chaotic-distractor/optical_contacting/README.md

# optical_contacting

https://allendowney.github.io/ModSimPy/chap15.html
