chaotic-distractor/optical_contacting/_SURF2022/report/LIGO_SURF_Interim_Report_2_draft1/parts_list/interim_report2.tex

\documentclass[colorlinks=true,pdfstartview=FitV,linkcolor=blue,
            citecolor=red,urlcolor=magenta]{ligodoc}

\usepackage{graphicx}
\usepackage{amssymb}
\usepackage{amsmath}
\usepackage{longtable}
\usepackage{rotating}
\usepackage[usenames,dvipsnames]{color}
\usepackage{fancyhdr}
\usepackage{subfigure}
\usepackage{hyperref}
\usepackage{array}
\usepackage{subcaption}

\usepackage{appendix}

\title{Methods of Improving Optical Contacting

Second Interim Report}

\author{Jennifer Hritz}

\begin{document}

\section{Work completed}

Where I left off in first interim report: after spending a few weeks designing bond quality tests, I had finalize the design for heating the glass slides and was preparing to start actual bonding. Since then, I have been experimenting with the different bonding methods, exploring what factors into creating a strong bond between glass slides. For a theoretical discussion on the different bonding methods, see Appendix TBD.

\subsection{Hot plate}

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

\subsection{Bonding}

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

\begin{figure}
\begin{center}
\begin{subfigure}
  \centering
  
  \caption{After bonding attempt.}
  \label{fig:kimwipe_bond_sfig1}
\end{subfigure}
\begin{subfigure}
  \centering
  
  \caption{The bond briefly holding.}
  \label{fig:kimwipe_bond_sfig2}
\end{subfigure}
\begin{subfigure}
  \centering
  
  \caption{Failure of the bond.}
  \label{fig:kimwipe_bond_sfig3}
\end{subfigure}
\caption{These demonstrate the failure of a bonding attempt using just Kimwipes to clean the glass.}
\label{fig:kimwipe_bond}
\end{center}
\end{figure}

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

\section{Progress}

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

\section{Problems}

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

\section{Goals}

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

\end{document} 

\begin{appendices}

\section{test}

\end{appendices}
