chaotic-distractor/optical_contacting/example_docs/Ph_70_article_hritz.pdf

# Optical Contacting and Its Application in LIGO

Jennifer Hritz

Common sense dictates that joining two surfaces at room temperature is impossible without the use of an adhesive. However, doing so is in fact incredibly easy. Optically contacting, also known as direct bonding, can adhere two flat, polished surfaces simply by pressing them together. No additional substances or chemical reaction necessary! Although seemingly magical, it works by the rather simple phenomenon of van der Waals forces.
Van der Waals forces are the collective electrostatic forces between two neutral particles. The attractive potential between two particles at distance. The attractive potential V (r) between two particles at distance r can be estimated as,

V (r) = −

C
r

6

where C is the interaction constant. This means that, when we increase the distance between two particles from 1 m to 10 m, the potential decreases by a factor of 10⁶ .
In other words, the attraction between the two particles steeply drops off when they are moved even slightly farther apart. Thus, van der Waals forces are only strong at very small distances.
Van der Waals forces are actually composed of three categories of interactions: Keesom force, Debye force, and London dispersion forces [1, 2]. All of these forces relate to the electrostatic attraction of electric dipoles (Figure 1). To understand this attraction, start with the structure of molecules. All atoms have an electronegativity. This refers to an atoms tendency to attract electrons from other atoms in a chemical bond, which depends on its size and number of protons. When atoms bond together, if the difference in electronegativity is great, the resulting molecule is a polar molecule. The more electronegative atom will attract the electrons from the other atom(s) in the bond. The attracted electrons group to create a negatively charged region, while the loss of electrons in other regions creates a positive charge. The most well known example of this is water, or H2O, where oxygen is the more electronegative atom.
Polar molecules are, in essence, permanent dipoles, since an electric dipole refers to any separation of positive and negative charges. Instantaneous dipoles work on the same principle as permanent dipoles, but they are merely temporary fluctuations in the distribution of electrons. Since positive and negative charges attract, both

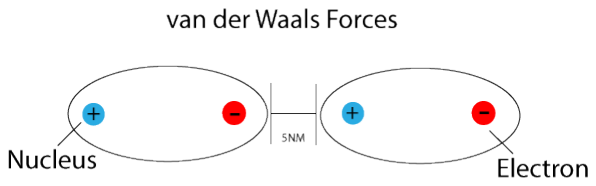
[picture p13: figure]

Figure 1: Simple diagram of van der Waals forces [a]. (https://revisionscience.com/a2-level-level-revision/chemistry-level-revision/bonding-and-structure/van-der-waals-forces)

types of dipoles play a key role in the three types of van der Whaals forces.
The first two forces, Keesom force and Debye force, are rather similar as they both arise from permanent dipoles [1]. Keesom force, also called dipole—dipole interactions, comes from the interaction energy between two permanent dipoles of moment µ1 and µ2 at distance rf,

V (r, θ1, θ2, ϕ) = −

µ1µ2(2 cos θ1 cos θ2) − sin θ1 sin θ2 cos ϕ 4πκϵ0

1
r

3

To derive the interaction, also known as the Keesom energy, we take the average over all angles weighted with the Boltzmann factor [3], which gives the ratio between two states of a system occurring. For this application, the Boltzman factor accounts for the system’s preference towards angles that have the lowest energy. Otherwise, all angles would be equally likely, leading to an average of zero. Thus, after a lengthy calculation, we get [3],

Vo(r) = ⟨V (r)⟩ = ⟨V (r, θ1, ...)e

−V (r,θ1,...)/kBT
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
(4πϵ0)

2(3kBT)

where ϵ0 is the vacuum dielectric constant, kB is the Boltzmann’s constant, and T is the absolute temperature [1, 3]. Note how it scales by a factor of 1/r⁶
Next, Debye force, also called dipole-induced-dipole interactions, results from a polar particle inducing a temporary dipole on a non-polar particle. Similar to Keesom force, for dipole moments µ1 and µ2 and polarizabilities α1 and α2 [1]:

Vi(r) = −

1
r

6

1
(4πϵ0)

2

(µ

2
1α2 + µ

2
2α1)

Once again, note how it scales by a factor of 1/r⁶ .

Finally, we have London dispersion forces, also called dispersion interactions
[2] or temporary fluctuating dipole interactions, result from instantaneous dipoles. Electrons are constantly in motion and sometimes that motion results in an uneven distribution of charge about the nucleus, creating a temporary dipole, which leads to attraction in the same way as mentioned previously. This is arguably the most important of the three van der Waals forces as it can occur between any two particles, unlike the others which necessitate inherent polarization for at least one particle. The strength of London dispersion forces depends on the size and shape of the particle. Larger molecules and atoms experience a stronger force because their valence electrons are farther from the nucleus and are therefore freer to move to induce a dipole. For molecules, some are shaped in ways that allow them to more effectively come in contact with one another [1, 4]. The time average interaction energy for polarizabilities α1 and α2 and electron orbiting frequencies ν1 and ν2 [1]:

Vd(r) ≈ −

1
r

6

3
2

α1α2
(4πϵ0)

2

ℏν1ν2
(ν1 + ν2)

where ℏ is Planck’s constant. Although redundant at this point, note one final time how it scales by a factor of 1/r⁶
Thus, if we sum these interactions, we get the total interaction energy.

V (r)vdW = Vo(r) + Vi(r) + Vd(r)

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
(4πϵ0)

2(3kBT)

+

1
(4πϵ0)

2

(µ

2
1α2 + µ

2

2α1) + 3
2

α1α2
(4πϵ0)

2

ℏν1ν2
(ν1 + ν2)

≈ −

C
r

6
Taking the negative derivative of the energy with respect to the distance to get the force [1],

FvdW (r) = −

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
we see that it scales by an even smaller factor of 1/r⁷
. Overall, this derivation emphasizes how optical contacting is theoretically possible between any two materials, and more critically, that it requires very, very small distances to be strong. The latter is most important because it is the crux for a successful direct bond. Although optical contacting could theoretically work between any two surfaces, silicon—both in its pure crystal state and as silicon dioxide in the form of glass— works best and has the largest range of applications. The name ”optical” in optical contacting refers to glass optics (Figure 2). Because these lenses are typically highly polished, their flat surfaces are perfect for bonding. The flatter the surface, the smaller the distance between the atoms, and therefore the stronger the bond.

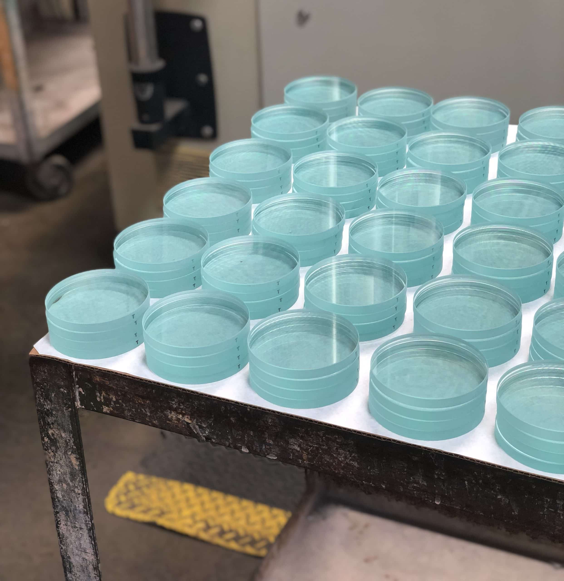
[picture p14: figure]

Figure 2: Example of optical glass [b]. (https://www.swiftglass.com/blog/what-is-optical-glass/)

So far we have only described the van der Waals interactions between two particles, not an entire lattice of atoms, but from our previous work, we can easily obtain the potential between two surfaces. For simplicity, we will ignore any repulsion; this includes repulsion from the Pauli exclusion principle, which comes from overlapping electron clouds [1]. We start by estimate the attractive forces between a particle at distance D from a plane. Integration gives us the potential between said particle and every particle in a surface with ρ particles per unit volume [5].

V (D) = Z +∞

D

dz

Z 2π

0

dϕ

Z π/2

0

dθ
ρ
−

C cos⁶
θ
z

6

× z tan θ

z
cos² θ

= −

πρC
6D³
For two surfaces, simply integrate over every particle in an additional surface of ρ

′
particles per unit volume. From this, we can get the force per unit area like before, which in this case is the bonding strength in the form of pressure.

V˜ (D) = Z +∞

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
πρρ′C
12D²

= −

πρρ′C
12D²

= −

A
12πD²

P(D) = ∂V˜ (D)
∂D =

A
6πD³
Here A = π

2ρρ′C is the Hamaker constant. For quartz glass, A ≃ 0.6 × 10⁻¹⁹J. Plugging this and experimental measurements of P(D) into the above equation, we find that the gap between the surfaces is roughly 1.9–1.2nm [5]. This is roughly equivalent to the thickness of a strand of DNA.
To actually achieve a gap this small, the two surfaces need to be carefully prepared before bonding. For glass, this means precision polishing. Ideally in a clean room, both glass and silicon wafers must be cleaned of impurities, typically with a chemical. For example, in the case of cleaning with methanol, the liquid is squeezed onto paper for cleaning optics then surface is firmly scrubbed. For glass, one should apply enough pressure to making a squeaking noise. Although performing the bond under compressed air to avoid re-contamination of dust increases the success of the bond, some success can be found even with slightly dusty conditions. In fact, while proper preparation is necessary for a strong bond, it is still relatively easy to achieve some degree of bonding, even under non-ideal conditions. As such, while optical contacting may seem like a recent invention enabled only by advances in the technology of manufacturing flat surfaces, this phenomenon has been known for at least a thousand years.
One of the first clear mentions of optical contacting comes from the 13th century Franciscan friar Bartholomaeus Anglicus [6], who wrote in his encyclopedia “On the genuine properties of heavenly, terrestrial, and infernal things:”

When a plate of gold is to be merged with or joined to a plate of silver, one needs to keep in mind three things: dust, air, and moisture. If any dust, air, or moisture comes between the two plates, they cannot be joined together, the one to the other. Therefore it is necessary to join these two metals together in a completely clean and still place. And when they are joined together in such a manner, they become so inseparable that they cannot later be taken apart. [6, 7]

This quote is included in its entirety because of how remarkably perfect it describes optical contacting hundreds of years before Johannes Diderik van der Waals was even born. We now know a bond is performed successfully, the two surface indeed effectively merge into one.
It was not until the 20th century that people began to take a closer look at optical contacting, although it was initially regarded as a nuisance. As German craftsmen perfected the art of polishing glass for optics, they observed this phenomenon, calling it “ansprengen.” In the 1930s, J.W. Obreimoff began work on measuring the strength to separate two optically contacted mica sheets. He measured the energy to split the sheets by wedging glass of thickness h in the gap between mica lamina of thickness d and a thick, parent block. This is an early example of what would become known as the ”razor test” [6].

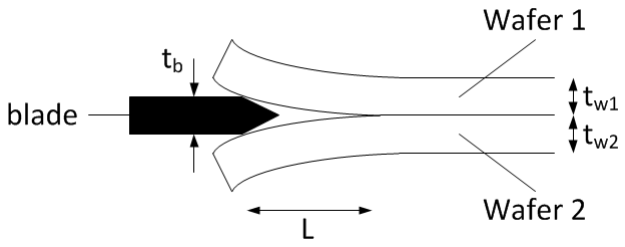
[picture p15: figure]

Figure 3: Diagram showing the razor test [c]. (https://en.wikipedia.org/wiki/Wafer_bond_characterization)

The double cantilever beam test, colloquially called the razor blade method, uses the elastic forces of the bonded surfaces to estimate bond strength. As derived in Tong and G¨osele’s ”Semiconductor Wafer Bonding” [8], let us consider a bonded pair of two beams of the same materials, both of width w. A razor blade of thickness tb is inserted in the gap between the two beams. The bent parts of each beam both have elastic energies Eelas, which is a function of their Young’s modulus E and thickness tw. At the equilibrium crack length L, the blade produces two new surfaces of area L × w. The total energy is given by

Etotal = 2(Eelas + γLw)

where γ is the surface energy of the two newly generated surfaces. Substituting in

Eelas

Etotal = 2

wEt³
wt

2
b
32L³

+ γLw

The 2 comes from the two beams having identical properties. In the case of them having dissimilar materials, we would have 2Eelas → Eelas1 + Eelas2 and 2γ → γ1 + γ2. The equilibrium between the elastic and bonding forces occurs at the critical point of Etotal.

∂Etotal
∂L = 0 → γ =

3Et³
wt

2
b
32L⁴
Thus, if the Young’s modulus E, wafer thickness tw, blade thickness tb, and crack length L are known, we can estimate the strength of the direct bond. This is important for applications of optical contacting as we need to know if the bond will be strong enough to not break under whatever stress it will experience.
Despite existing in some capacity for many years, optical contacting of both glass and silicon is still seen as a under-researched and underutilized phenomenon. One potential application is with the planned LIGO Voyager upgrade. LIGO (Laser Interferometer Gravitational-wave Observatory) is a highly sensitive detector which measures the gravitational waves produced by black hole mergers and other massive celestial events.
”Strong” gravitational waves are produced when two massive celestial objects— typically two neutron stars or two black holes—merge. The inspiral and eventual merger of two massive bodies produce waves which travel light years to be picked up by scientists on earth (Figure 4). I placed ”strong” in quotations because the strong waves we detect are actually incredibly small. Gravitational waves create distortions around the 10⁻18 meters, roughly 1000 times smaller than the diameter of a proton [9].

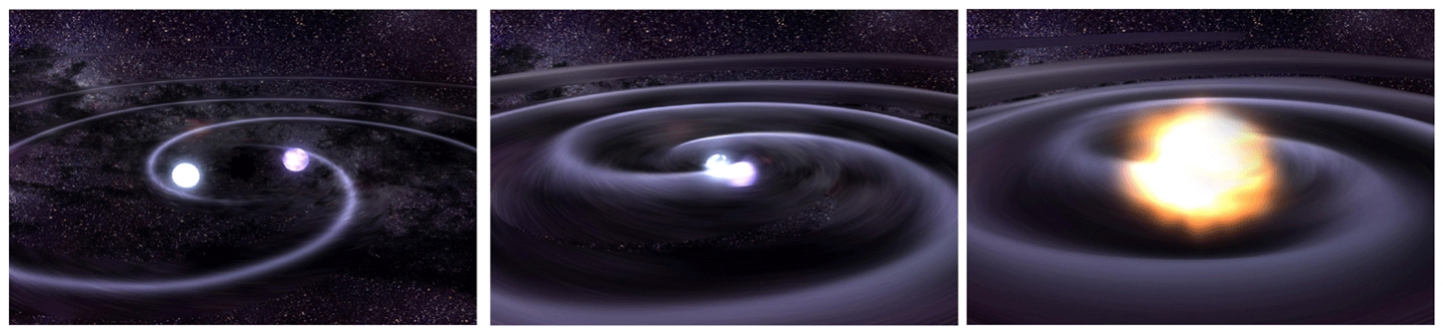
[picture p16: figure]

Figure 4: Diagram showing the razor test [d]. (https://www.ligo.org/science/GW-Inspiral.php)

NOTE (2/9/2023): The rest of this article is more or less copied from my SURF report. Re-reading it, I’m not sure if my description of suspension thermal noise is entirely accurate. I also have spent more time researching it since then, so I might write a v2 with more in-depth math/physics.

To detect something that small, we need incredibly sensitive equipment! Briefly, LIGO archives this with destructive interference between two very stable lasers. When two light beams are in the correct phase, they cancel each other out, so no light is produced. This is called destructive intereference. LIGO’s light beams bounce back and forth between two mirrors 4 km apart in a phase that perfectly destructively interferes. When the gravitation waves distort the space-time ever so slightly, the distance between the two mirrors is changed by a very small amount, shifting the phase of the beams so they no longer destructively interfere. This means that some light is able to get through, which we record as a signal [9].
Trying to keep a laser beam 4 km long—equivalent to 40 American football fields—perfectly stable is huge challenge. Although LIGO was operation starting in 2002, it would take another 13 years to first detect gravitational waves. The first iteration of the detector, Initial LIGO (iLIGO), lacked sufficient sensitivity, and it was not until the upgrade, Advanced LIGO (aLIGO), was completed in 2015 that a black hole merger was finally observed. This upgrade made the detector 10 times more sensitive. One of the major changes was to the suspension system, which holds the glass mirrors. The single pendulum was replaced with a more stable quadruple pendulum [10].
Currently, aLIGO is undergoing an upgrade called “A+” to increase the sensitivity by 50%. LIGO Voyager is a future planned upgrade which aims to be a significant improvement to aLIGO; it will extend LIGO’s range by a factor of 4-5 and increase the frequency of detections 100 fold. Voyager will increase sensitivity by limiting background noise. To archive this, one of the changes will be to replace the glass mirrors (also called test masses), and the silica fibers which suspend them, with cryogenically cooled silicon [11].
Silicon has many advantages over glass. When cooled below 123 K, it has effectively zero thermo-elastic distortion, which subsequently greatly decreases thermo-elastic noise. This makes it particularly useful for high sensitivity probes [12, 11]. The quadruple pendulum system was an upgrade to the single pendulum because the multiple pendulums increased stability thereby reducing seismic noise. It still suffers from thermal noise from the coating and suspension of the test masses, something Voyager aims to fix [13].
Suspension thermal noise arises from vibrational modes in the system. Assuming the test mass and suspension ribbons are homogenous—all silicon in the case of Voyager, the modes will be nearly orthogonal, allowing the complex system to be split into single, one-dimensional harmonic oscillators. Adding the thermal noise from each harmonic oscillator gives the total thermal noise for the modes in the system. These normal modes can be decomposed into pendulum and violin modes [14].
For the pendulum modes, consider a lossless system of a point-like mass swinging from a massless wire. The shape of this mode comes from the bending of the wire during the oscillation. The point of bending is determined by the tension from the test mass and the elastic properties of the wire. The violin modes are influenced by the same factors. The bouncing violin mode comes from the spring-like vibration of the wire [14].
Because these modes form distinctive noise peaks, they would be easy to calculate and remove from the data. However, this relies on the system being homogeneous, which it is not. Some form of adhesive must be used to attach the suspension ribbons to the test mass. Because the adhesive would have different elastic properties, the adhesive would move and flex in ways that dissipates energy and create additional, unpredictable modes. The distinctive peaks are muddled by the additional noise, making it harder for them to be removed from the data. Unlike traditional adhesives, optical contacting creates a bond which is solely composed of the two bonded surfaces. If the silicon ribbons are directly bonded to the silicon test mass, they would effectively become one homogeneous object with a well-defined set of normal modes. This is one of the many potential applications of optical contacting.

## References

[1] Zhang, X., Van der Waals Forces. Encyclopedia of Tribology (2013).
[2] Loskill, P., et al., Is adhesion superficial? Silicon wafers as a model system to study van der Waals interactions. Advances in Colloid and Interface Science (2012).
[3] https://nanohub.org/courses/AFM1/01a/asset/305
[4] https://www.chem.purdue.edu/gchelp/liquids/disperse.html
[5] Greco, V., Marchesini, F., Molesini, G., Optical contact and van der Waals interactions: the role of the surface topography in determining the bonding strength of thick glass plates. Journal of Optics A: Pure and Applied Optics (2001).
[6] Pl¨ossl, A., Krauter, G., Wafer direct bonding: tailoring adhesion between brittle materials. Materials Science and Engineering, R25 (1999).
[7] Anglicus, B., De genuinis rerum coelestium, terrestrium at inferarum proprietatibus rerum. Minerva (1964).

[8] Tong, Q.-Y., G¨osele, U., SemiConductor Wafer Bonding: Science and Technology. The Electrochemical Society Series (1999).
[9] https://www.ligo.org
[10] https://www.ligo.caltech.edu/page/about-aligo
[11] Adhikari, R., Arai, K., et al., LIGO Voyager: A Gravitational-wave Probe of Cosmology and Dark Matter. Snowmass2021 - Letter of Interest (2021).
[12] Wright, J. J., Zissa, D. E., OPTICAL CONTACTING FOR GRAVITY PROBE STAR TRACKER. 14 (1984).
[13] Westland, J., Finite Element Analysis of the Third Generation Mirror Suspension Systems for Voyager. SURF (2016).
[14] Lorenzini, M., SUSPENSION THERMAL NOISE ISSUES FOR ADVANCED GW INTERFEROMETRIC DETECTORS. UNIVERSITA’ DEGLI STUDI DI FIRENZE (2005-2007).
