chaotic-distractor/optical_contacting/for_elog/cycler_v3_graphs/PWM plates - 100 ms on, 9900 ms off.pdf

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

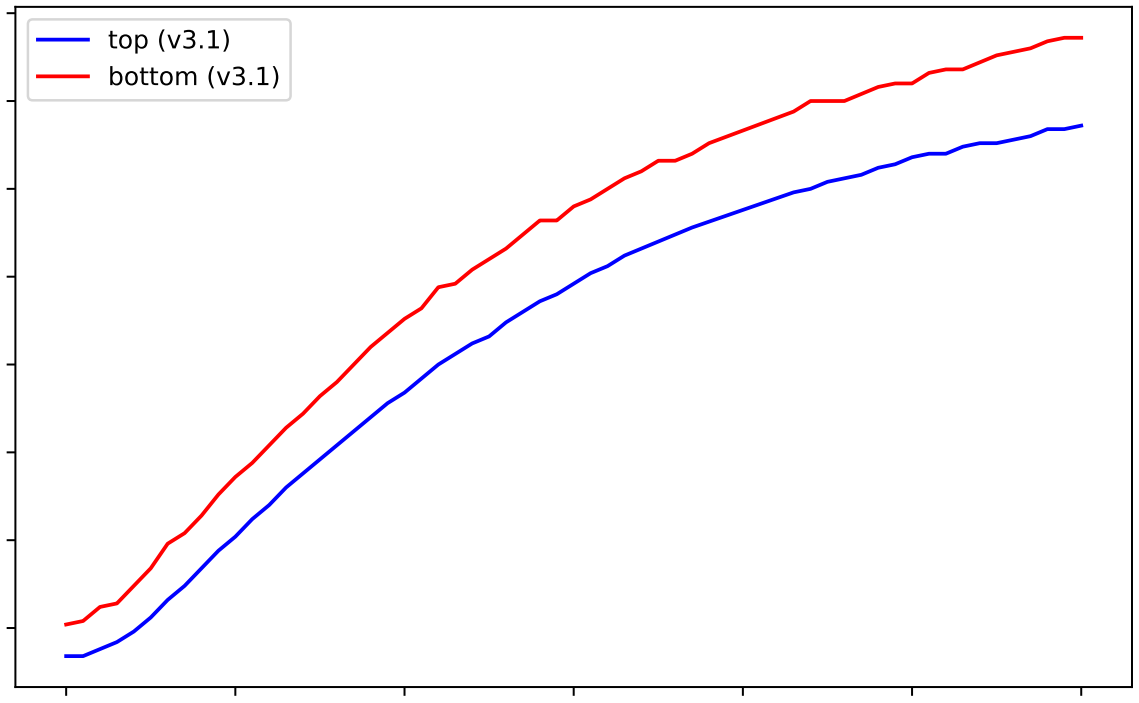
[picture p18: figure]
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
