chaotic-distractor/optical_contacting/for_elog/cycler_v3_graphs/PWM plates - 1000 ms on 9000 ms off.pdf

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

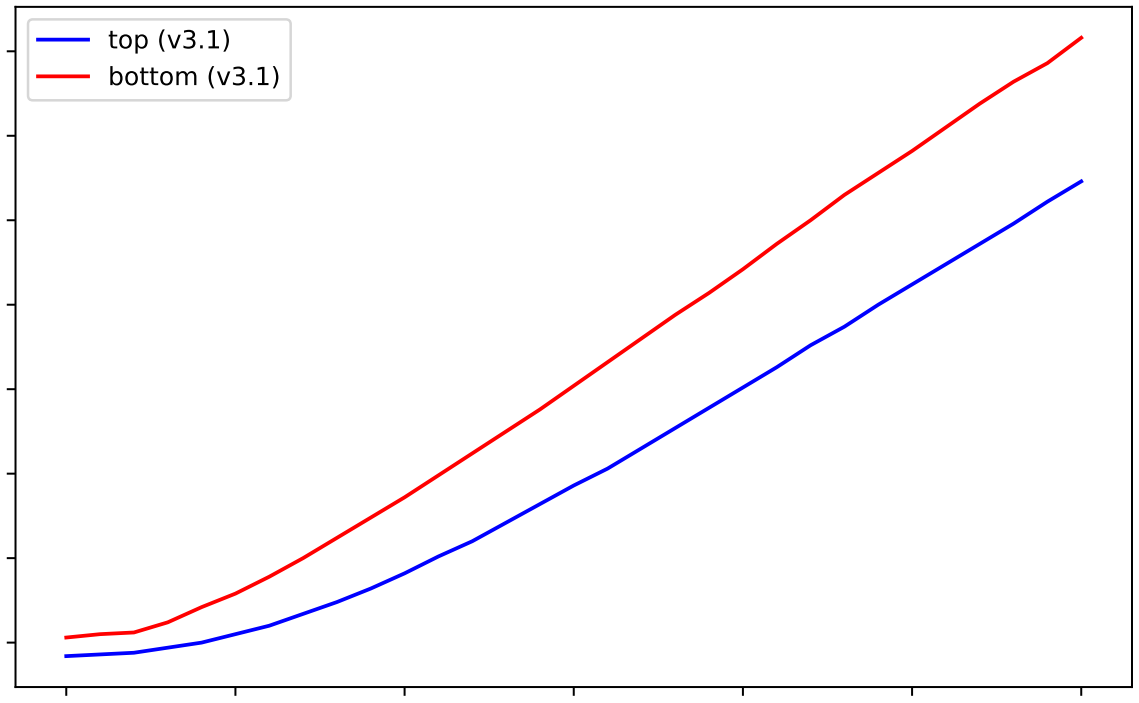
[picture p19: figure]
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
