chaotic-distractor/optical_contacting/for_elog/cycler_v3_graphs/PWM plates - increase 180°C in 10 minutes.pdf

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

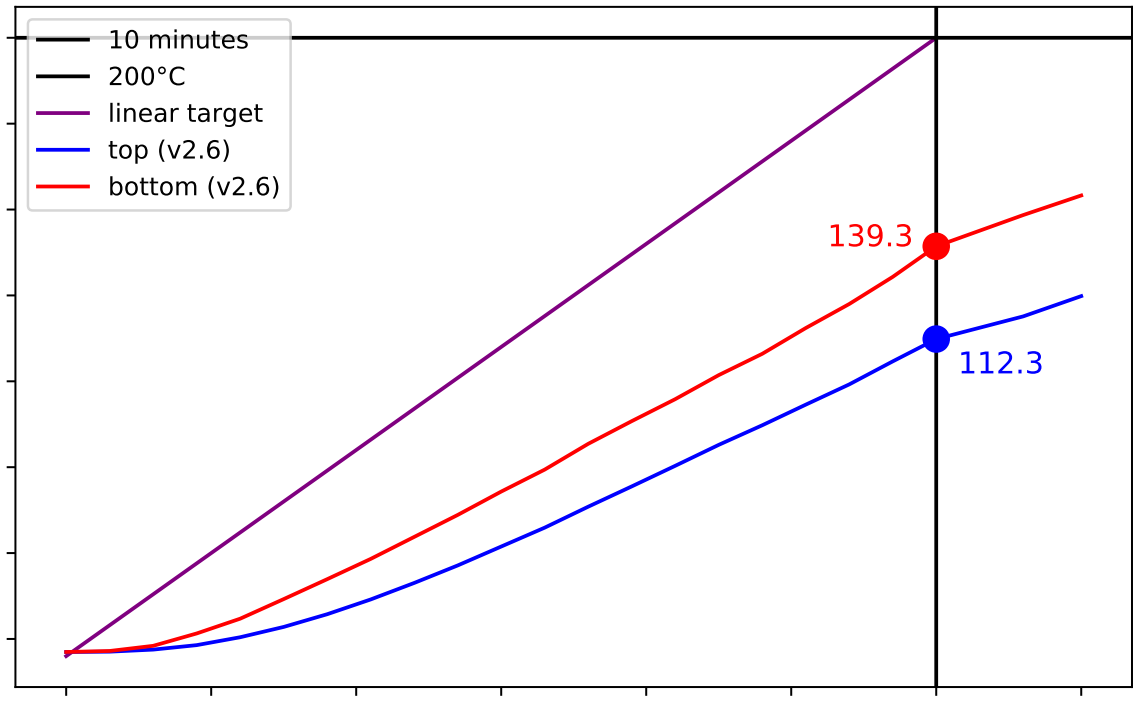
[picture p20: figure]
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
