chaotic-distractor/optical_contacting/_SURF2022/parts_list/bonding_proceedure_graphics/rough_design.jpg

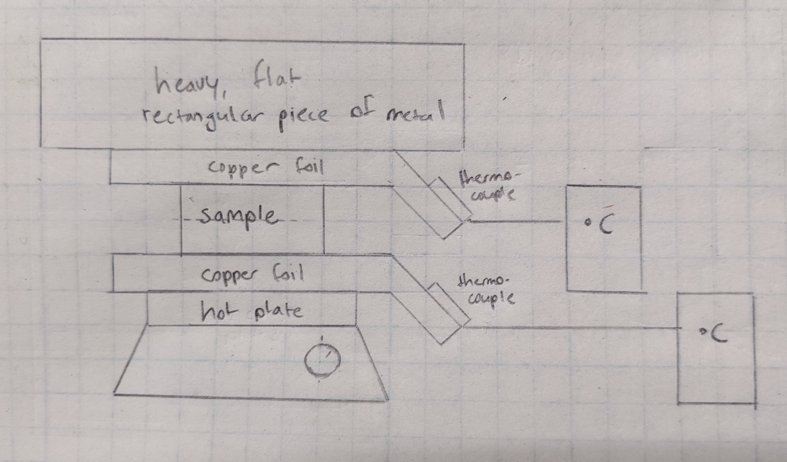
_SURF2022/parts_list/bonding_proceedure_graphics/rough_design.jpg
