chaotic-distractor/optical_contacting/_SURF2022/parts_list/shear_strength_graphics/shear_design_p2.jpg

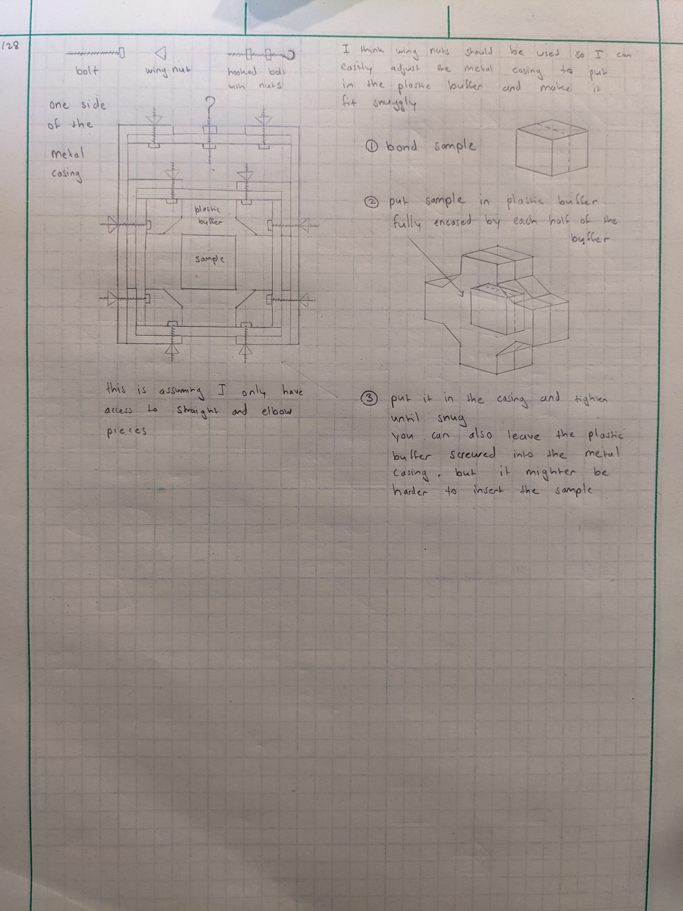
_SURF2022/parts_list/shear_strength_graphics/shear_design_p2.jpg
