chaotic-distractor/optical_contacting/_SURF2022/parts_list/shear_strength_graphics/shear_strength_overview.png

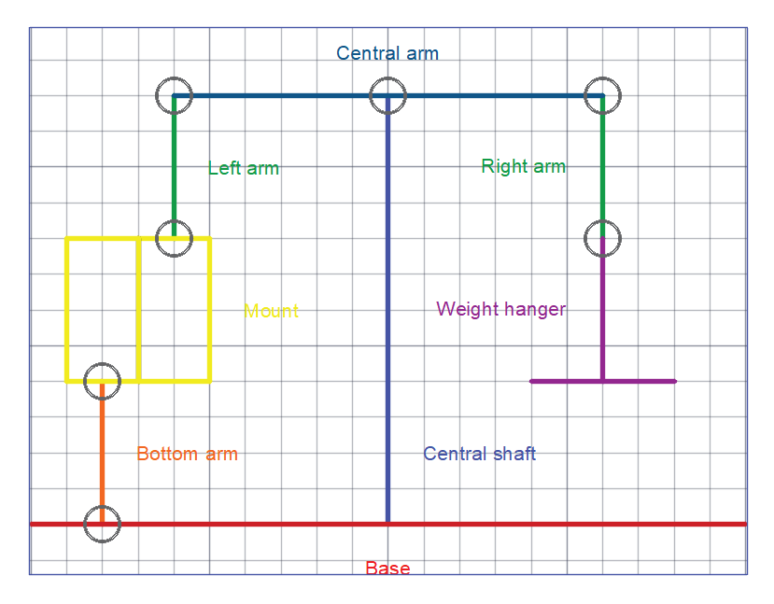
_SURF2022/parts_list/shear_strength_graphics/shear_strength_overview.png
