chaotic-distractor/optical_contacting/for_elog/lab_log_photos/2_weeks_pressure_PXL_20221004_190652540_20221017_074745619.jpg

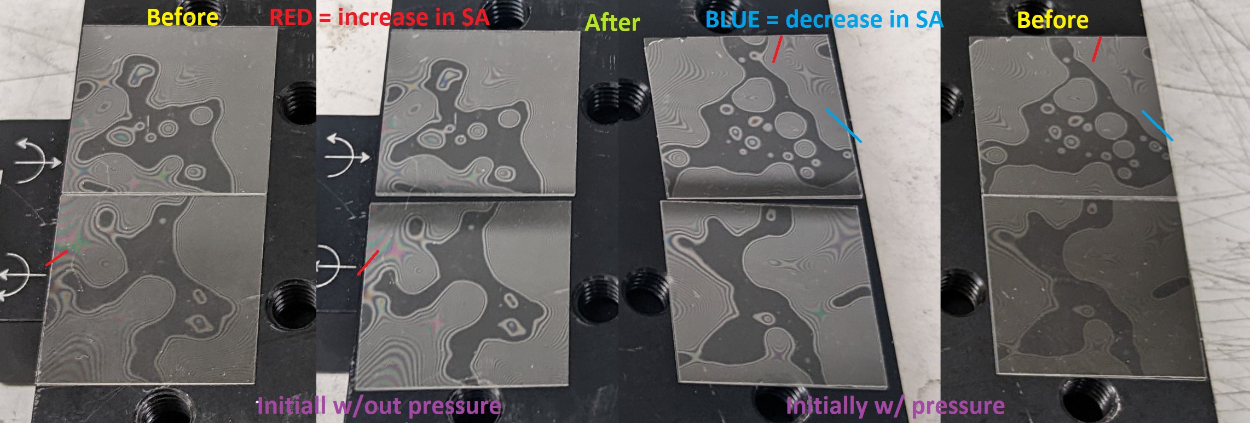
for_elog/lab_log_photos/2_weeks_pressure_PXL_20221004_190652540_20221017_074745619.jpg
