chaotic-distractor/optical_contacting/for_elog/lab_log_photos/before_time_on_left_pressure_on_right_PXL_20221003_061828860.MP.jpg

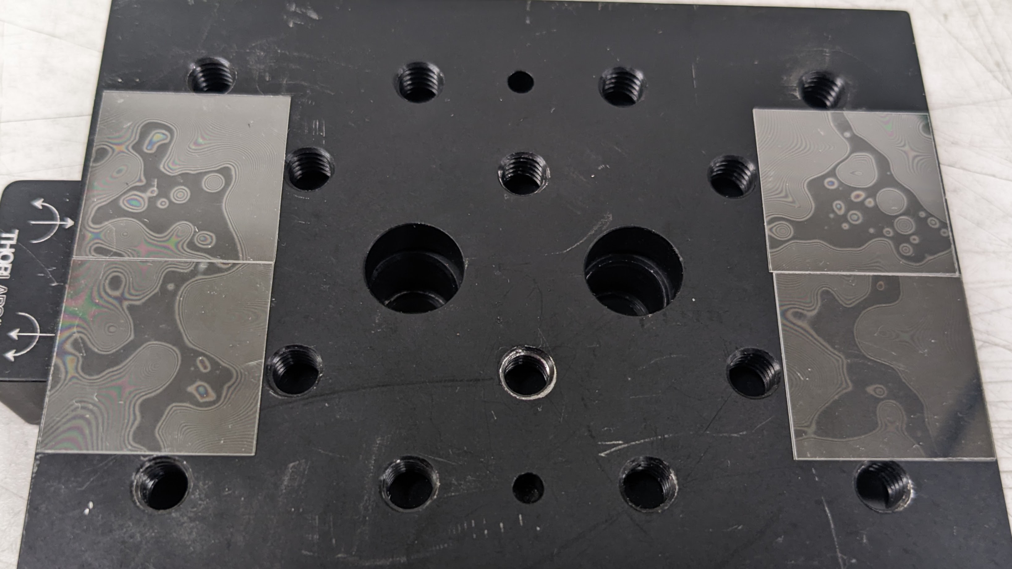
for_elog/lab_log_photos/before_time_on_left_pressure_on_right_PXL_20221003_061828860.MP.jpg
