chaotic-distractor/optical_contacting/for_elog/lab_log_photos/broken_and_fixed_thermocouple_PXL_20221020_042242792_20221020_042201775.MP.jpg

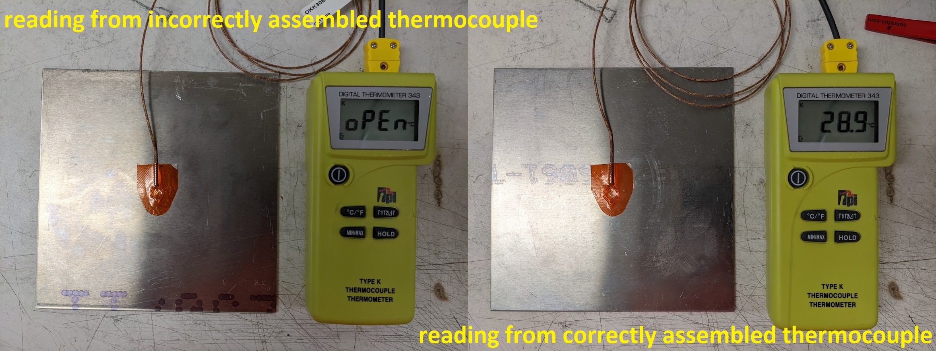
for_elog/lab_log_photos/broken_and_fixed_thermocouple_PXL_20221020_042242792_20221020_042201775.MP.jpg
