chaotic-distractor/optical_contacting/for_elog/lab_log_photos/correct_polarizatio_PXL_20221022_055117337.MP.jpg

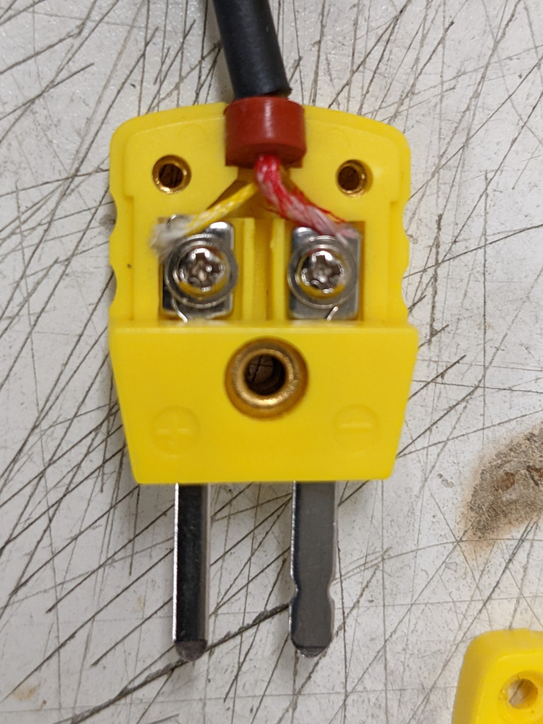
for_elog/lab_log_photos/correct_polarizatio_PXL_20221022_055117337.MP.jpg
