chaotic-distractor/optical_contacting/for_elog/lab_log_photos/heat_w_pressure_set_up_PXL_20221001_033228622.MP.jpg

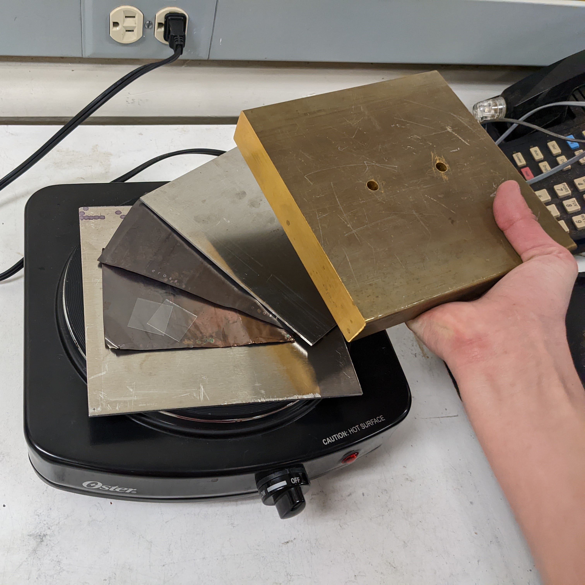
for_elog/lab_log_photos/heat_w_pressure_set_up_PXL_20221001_033228622.MP.jpg
