chaotic-distractor/optical_contacting/for_elog/lab_log_photos/in_progress_time_vs_pressure_PXL_20221003_062117715.MP.jpg

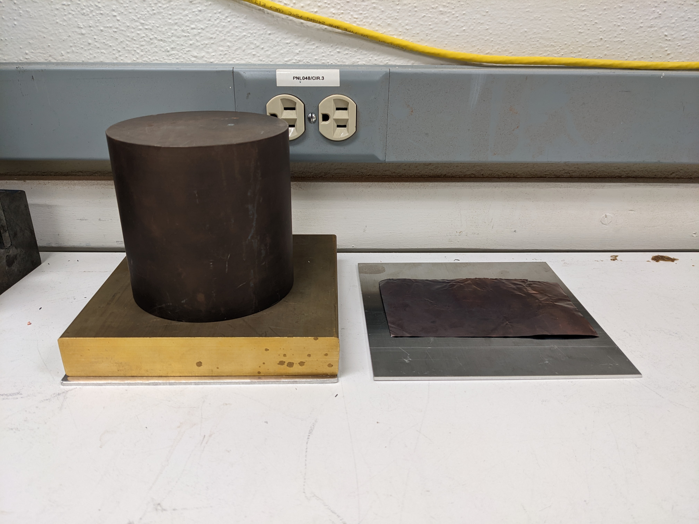
for_elog/lab_log_photos/in_progress_time_vs_pressure_PXL_20221003_062117715.MP.jpg
