chaotic-distractor/optical_contacting/for_elog/lab_log_photos/K_Type_connector_PXL_20221019_000708969.MP.jpg

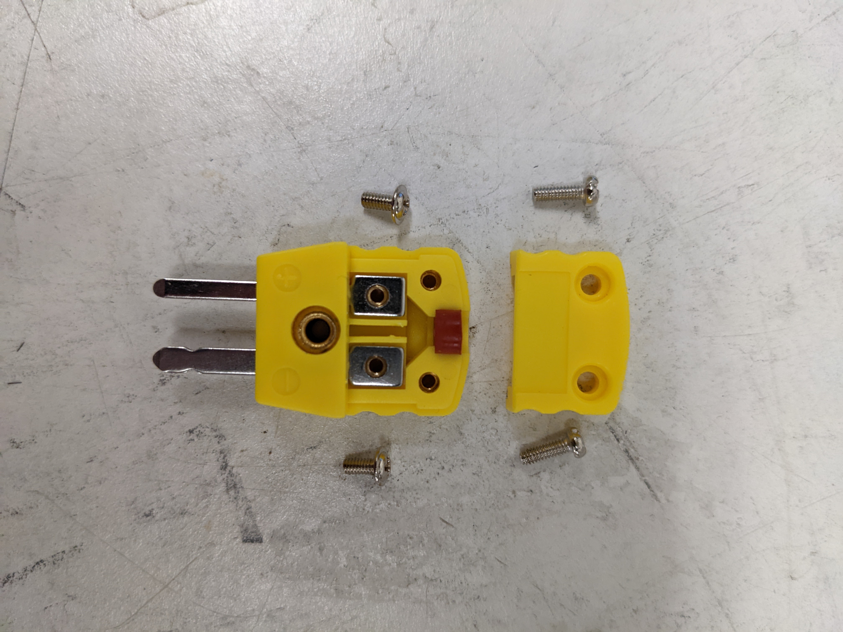
for_elog/lab_log_photos/K_Type_connector_PXL_20221019_000708969.MP.jpg
