chaotic-distractor/optical_contacting/for_elog/lab_log_photos/pressure_set_up_PXL_20221001_040539385.MP.jpg

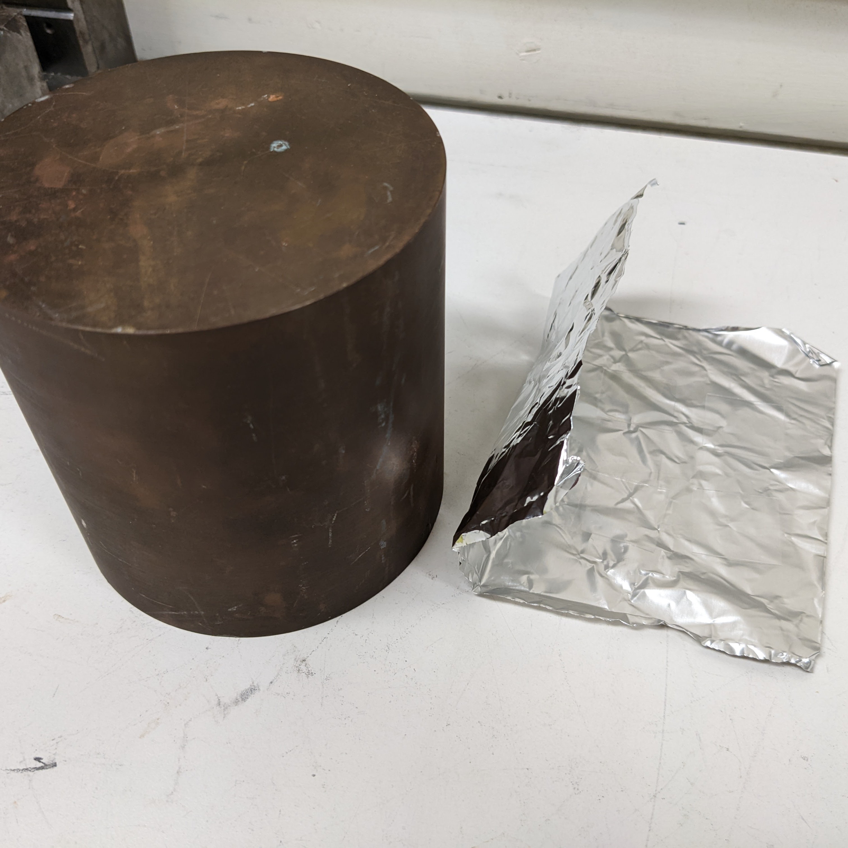
for_elog/lab_log_photos/pressure_set_up_PXL_20221001_040539385.MP.jpg
