chaotic-distractor/optical_contacting/for_elog/lab_log_photos/pressure_v_time_samples_both_PXL_20221003_061828860_20221004_190632199.jpg

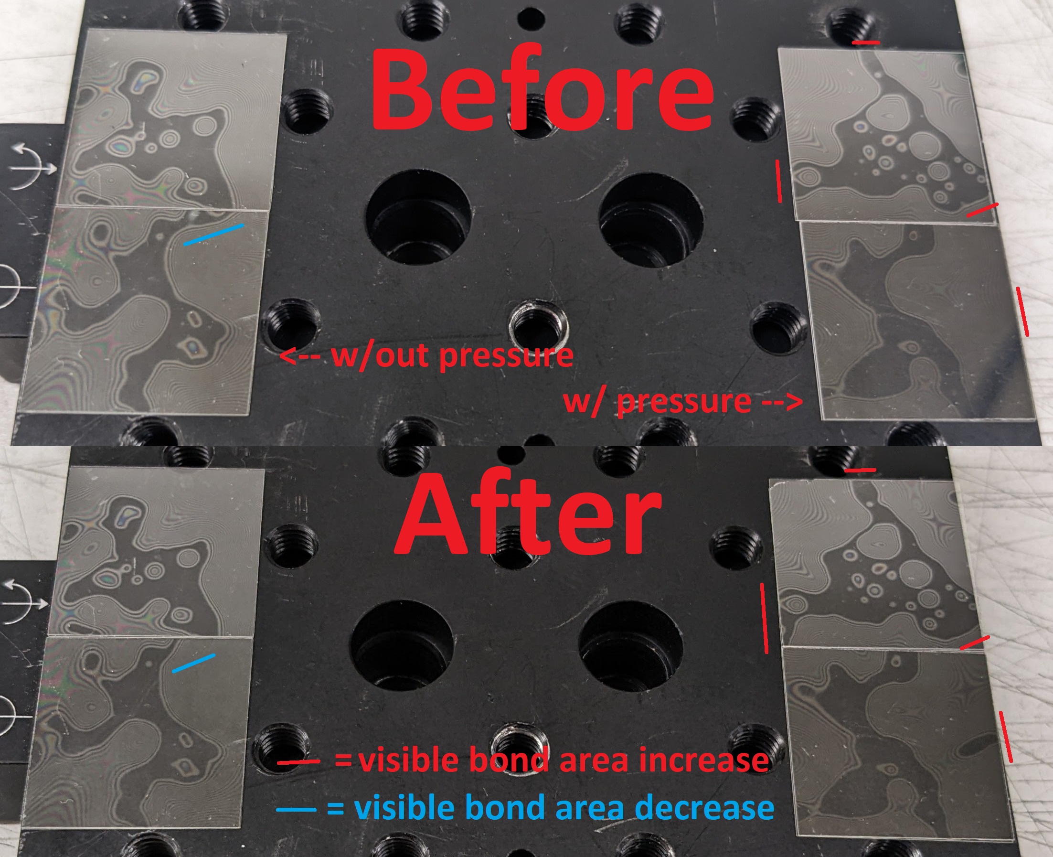
for_elog/lab_log_photos/pressure_v_time_samples_both_PXL_20221003_061828860_20221004_190632199.jpg
