chaotic-distractor/optical_contacting/for_elog/lab_log_photos/PXL_20221018_080838426.MP.jpg

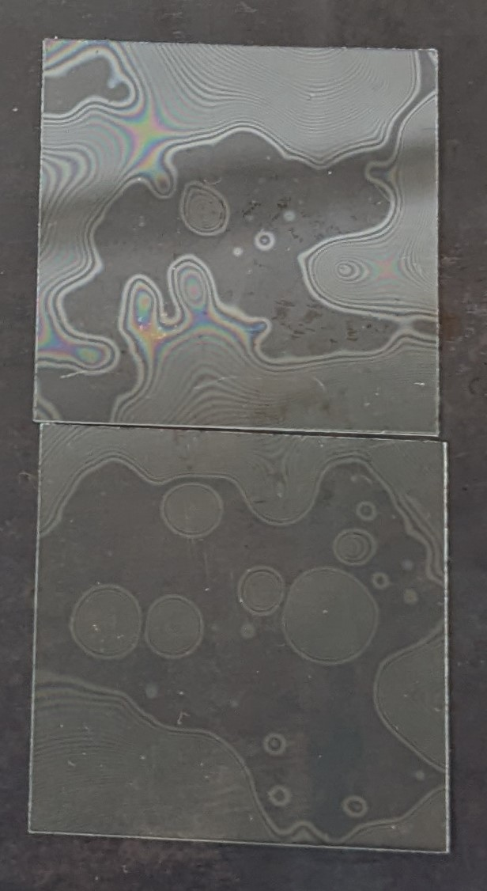
for_elog/lab_log_photos/PXL_20221018_080838426.MP.jpg
