chaotic-distractor/optical_contacting/for_elog/lab_log_photos/samples_before_AND_after_heat_w_pressure_PXL_20221002_053842185.MP.jpg

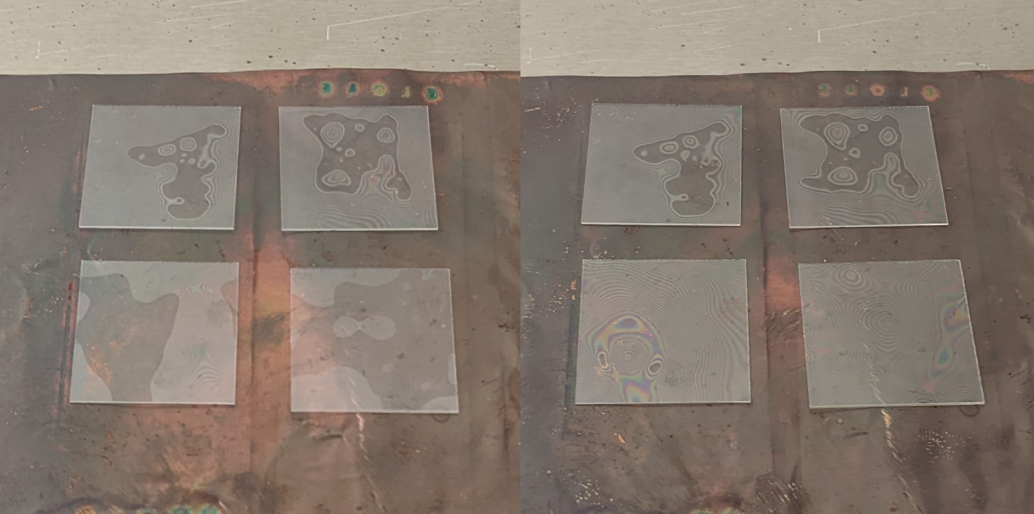
for_elog/lab_log_photos/samples_before_AND_after_heat_w_pressure_PXL_20221002_053842185.MP.jpg
