chaotic-distractor/optical_contacting/for_elog/lab_log_photos/samples_before_heat_w_pressure_PXL_20221001_034620991.MP.jpg

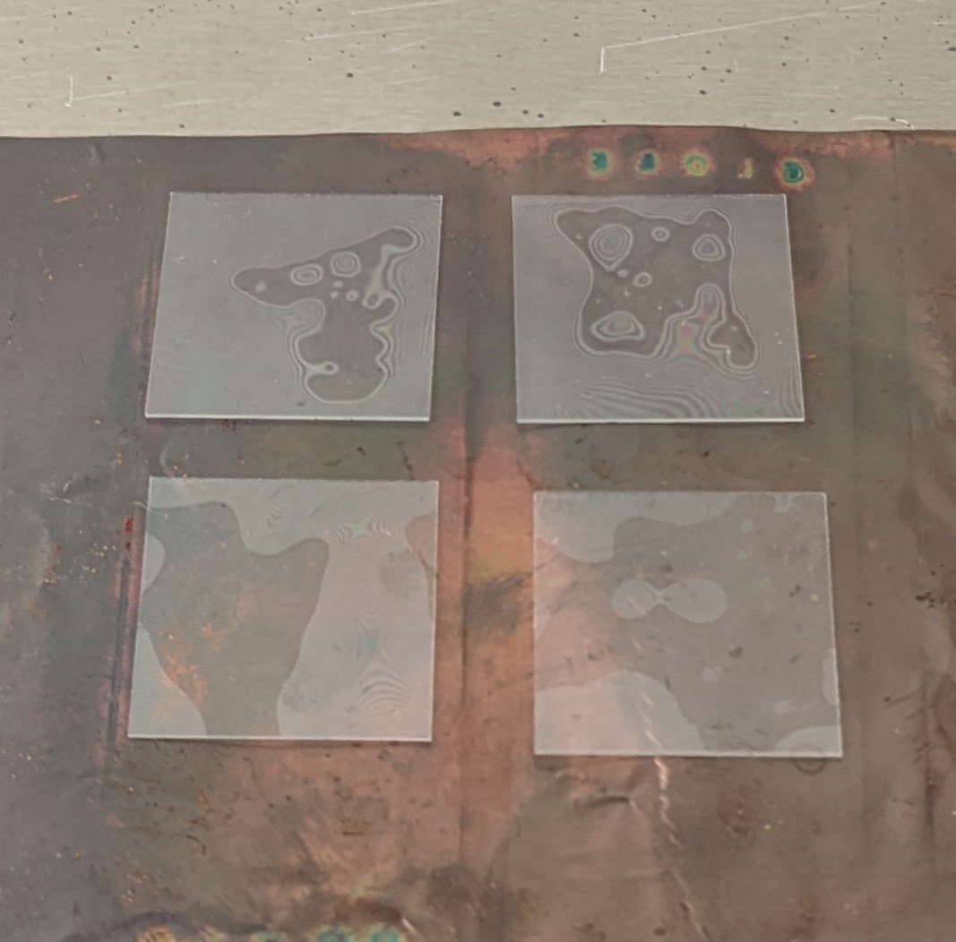
for_elog/lab_log_photos/samples_before_heat_w_pressure_PXL_20221001_034620991.MP.jpg
