chaotic-distractor/optical_contacting/for_elog/lab_log_photos/samples_before_pressure_PXL_20221001_040441662.MP.jpg

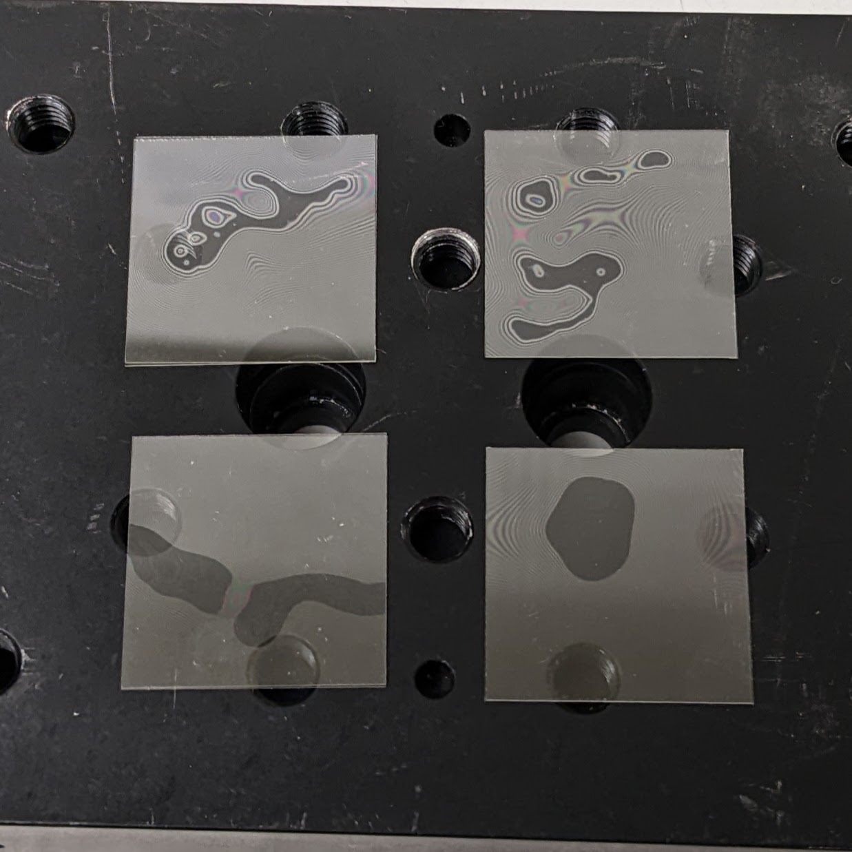
for_elog/lab_log_photos/samples_before_pressure_PXL_20221001_040441662.MP.jpg
