chaotic-distractor/optical_contacting/for_elog/lab_log_photos/thermocouples_and_thermometers_room_temp/T1_adhered_plate1_PXL_20221020_043843359.MP.jpg

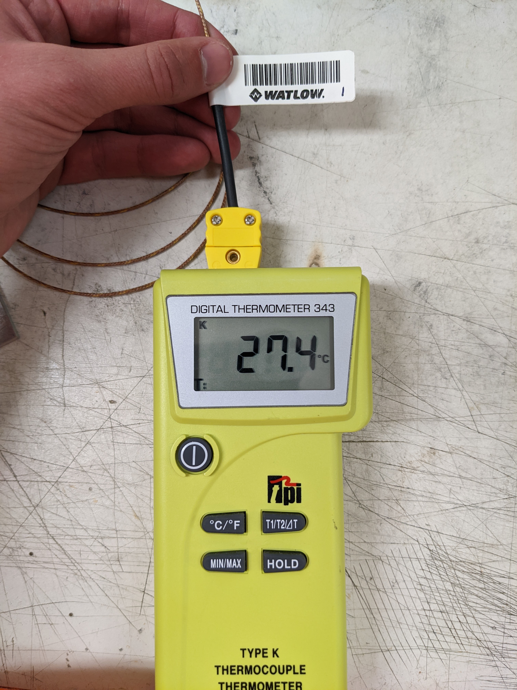
for_elog/lab_log_photos/thermocouples_and_thermometers_room_temp/T1_adhered_plate1_PXL_20221020_043843359.MP.jpg
