chaotic-distractor/optical_contacting/for_elog/lab_log_photos/thermocouples_and_thermometers_room_temp/T1_probe_plate1_PXL_20221020_044534275.MP.jpg

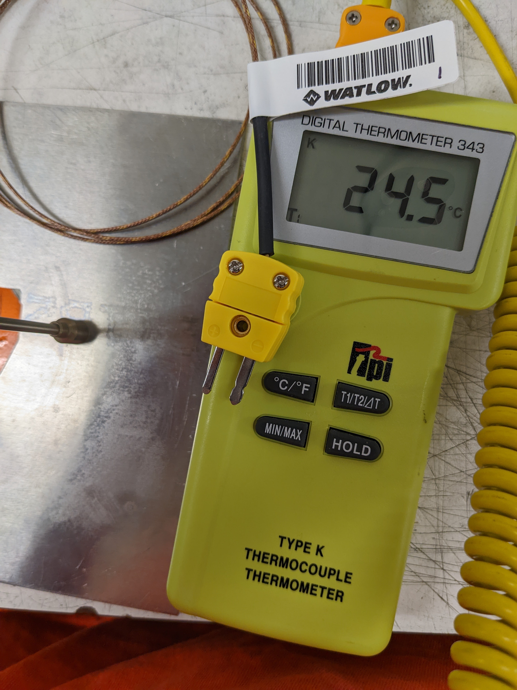
for_elog/lab_log_photos/thermocouples_and_thermometers_room_temp/T1_probe_plate1_PXL_20221020_044534275.MP.jpg
