chaotic-distractor/optical_contacting/for_elog/lab_log_photos/thermocouples_and_thermometers_room_temp/T2_probe_plate1_PXL_20221020_044446738.MP.jpg

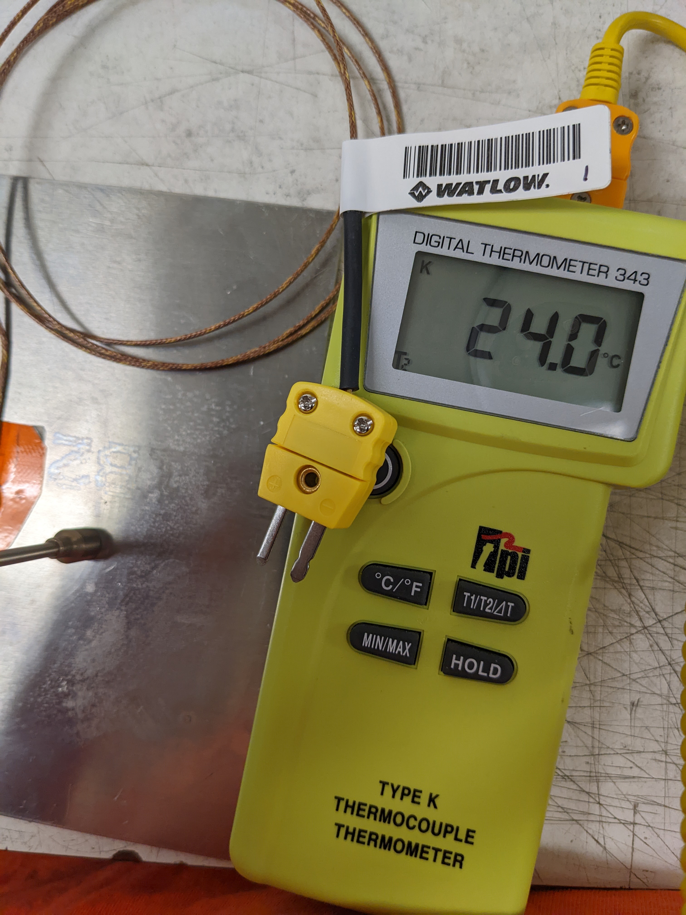
for_elog/lab_log_photos/thermocouples_and_thermometers_room_temp/T2_probe_plate1_PXL_20221020_044446738.MP.jpg
