chaotic-distractor/optical_contacting/for_elog/lab_log_photos/wrong_correct_polarization_PXL_20221022_054250498_20221022_055117337.MP.jpg

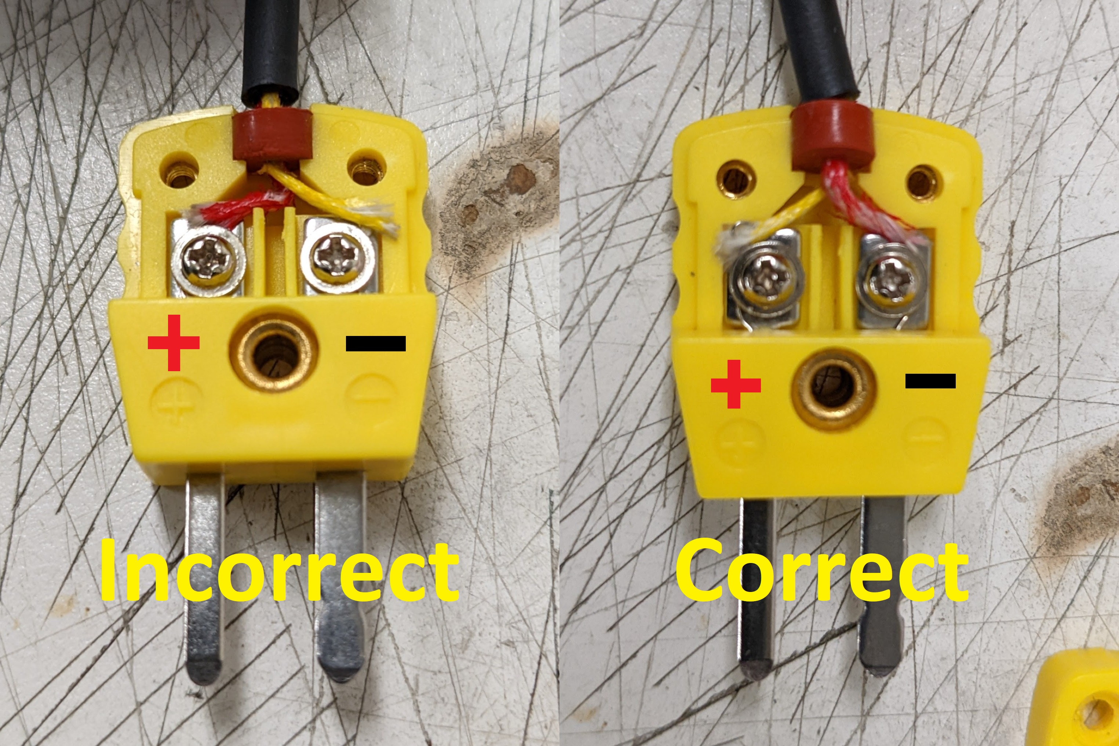
for_elog/lab_log_photos/wrong_correct_polarization_PXL_20221022_054250498_20221022_055117337.MP.jpg
