chaotic-distractor/optical_contacting/for_elog/lab_log_photos/wrong_polarization_PXL_20221022_054250498.MP.jpg

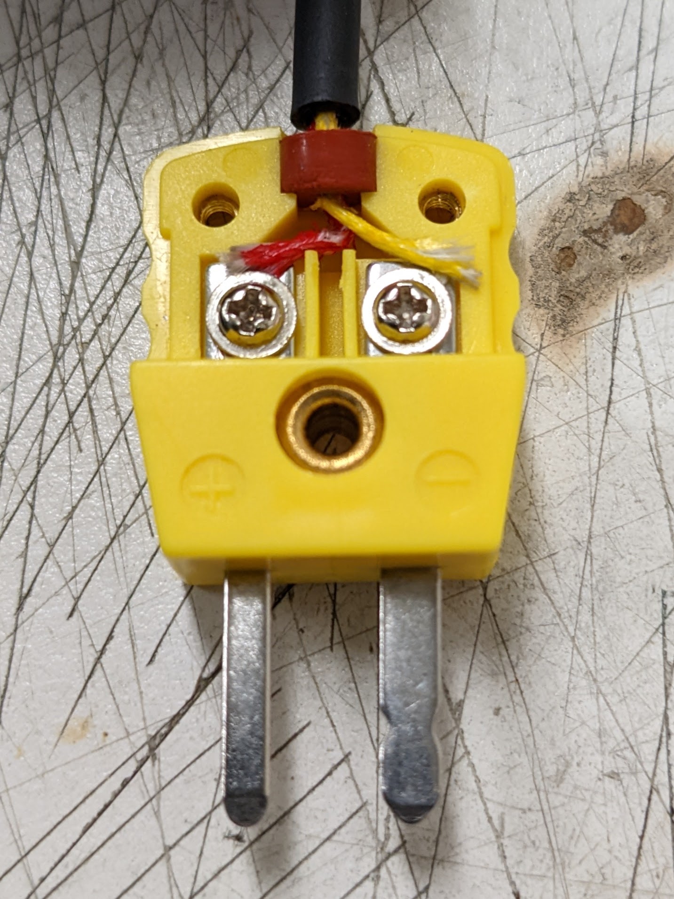
for_elog/lab_log_photos/wrong_polarization_PXL_20221022_054250498.MP.jpg
