chaotic-distractor/optical_contacting/new_hot_plate_code/Python/error_parse_raw_failed.jpg

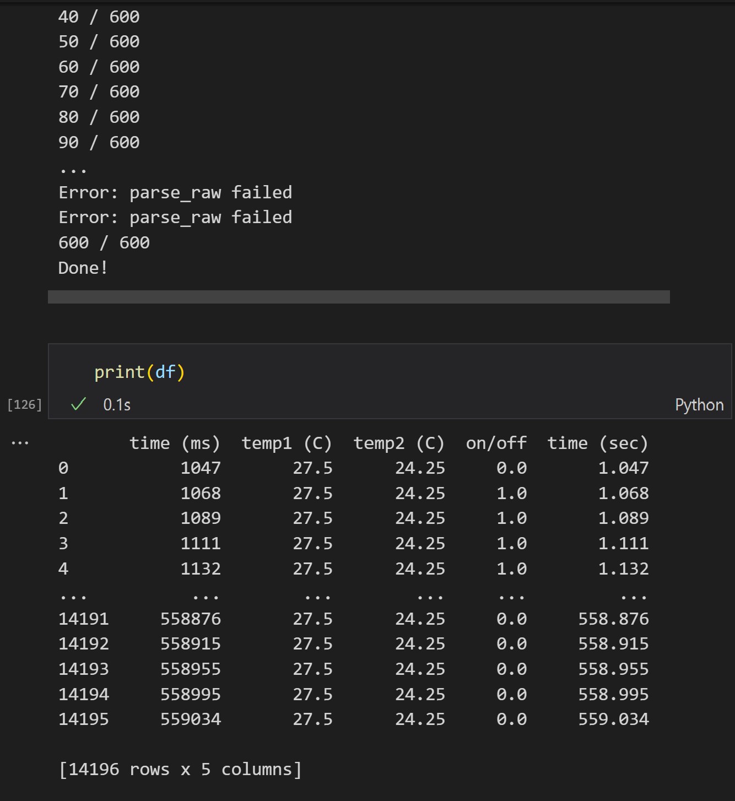
new_hot_plate_code/Python/error_parse_raw_failed.jpg
