chaotic-distractor/optical_contacting/new_hot_plate_code/Python/parse_raw_DID_NOT_fail.jpg

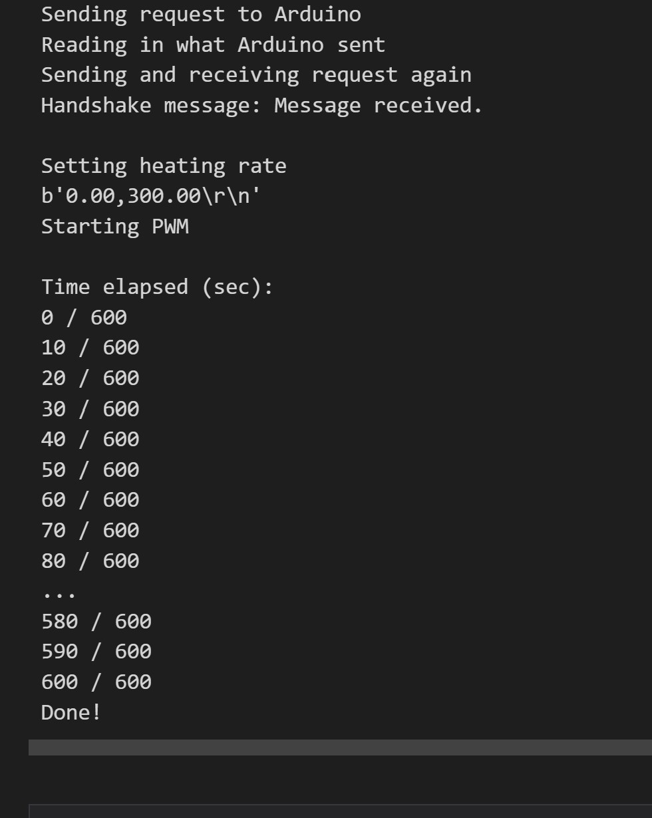
new_hot_plate_code/Python/parse_raw_DID_NOT_fail.jpg
