chaotic-distractor/optical_contacting/_SURF2022/report/LIGO_SURF_Interim_Report_2_draft1/parts_list/Appendix_parts_list.pdf

LASER INTERFEROMETER GRAVITATIONAL WAVE OBSERVATORY
- LIGO -
CALIFORNIA INSTITUTE OF TECHNOLOGY MASSACHUSETTS INSTITUTE OF TECHNOLOGY

2022/06/21

# Optical Contacting - THIS IS NOT THE ENTIRE DOCUMENT

Jennifer Hritz

California Institute of Technology | Massachusetts Institute of Technology
LIGO Project, MS 18-34 | LIGO Project, Room NW22-295
Pasadena, CA 91125 | Cambridge, MA 02139
Phone (626) 395-2129 | Phone (617) 253-4824
Fax (626) 304-9834 | Fax (617) 253-7014
E-mail: info@ligo.caltech.edu | E-mail: info@ligo.mit.edu
LIGO Hanford Observatory | LIGO Livingston Observatory
Route 10, Mile Marker 2 | 19100 LIGO Lane
Richland, WA 99352 | Livingston, LA 70754
Phone (509) 372-8106 | Phone (225) 686-3100
Fax (509) 372-8137 | Fax (225) 686-7189
E-mail: info@ligo.caltech.edu | E-mail: info@ligo.caltech.edu

http://www.ligo.caltech.edu/

## 1 Appendix # - Parts List/Experiment Design

### 1.1 Shear strength

My design was inspired by the apparatus used in a paper which was measuring the shear strength of a glass-glass direct bond [1]. The paper had a picture of their apparatus (Figure
1) but did not explain how their apparatus was constructed—most importantly, they did not explain how they mounted their wafers—so I had to design that myself.


Figure 1: ”Photograph of the setup used for shear strength measurements.” [1].

The shear strength is measured by mounting the optically bonded wafers on one side of a beam balance then slowly adding weight to the other side until the bond is broken. As shown in Figure 2, the bonded wafers are mounted such that weight pulls up one side while the other remains secure. A lab jack is used to assist with adding the weights.


Figure 2: My design of my apparatus and the mount for the bonded wafers as well as a crude diagram of how the apparatus functions.

Parts list:

1. Traditional beam balance
- I am not sure if this can be purchased or it will need to be constructed. It seems simple enough to me, but I could be underestimating its complexity.
- If it needs to be constructed, I can put together a list of the parts needed.
2. Various weights (total to roughly 100 kg)
- The idea is to slowly add smaller weights until you reach a certain amount then remove them and add a big single weight equivalent to their weight. Repeat until failure.
- I swear I have seen weights like in Figure 1 used in a lab class, so I presume they are not something that needs to be purchased.
3. Lab jack
- This is for taking the weight off the bonded wafers while replacing the smaller weights with the big single weight.
4. Mount for bonded wafers
- This was the hardest part to design since it needs to be a snug fit while also being capable of bearing weight. My idea is to 3D print a casing like in Figure 2. I am unsure if I can 3D print with a material strong enough to bear the weight, so perhaps metal should be attached around them. The mount is attached to the beam balance with a hook.
5. Bonded wafers
- These will be on the OOM of 10mm x 10m x 1mm. If it is cheaper/quicker to get a slightly different thickness (0.5mm looked more common based on a quick Internet search), that will work as well.
- It has to be fairly small otherwise it will be infeasible to add enough weight to break the bonds. The inspirational paper used similar OOM glass wafers and reported 75kg being the max it took to break them.

### 1.2 Index of refraction

Finding the absolute thickness and index of refraction of a thin film requires a technique known as ellipsometry. Basic ellipsometry is shown in Figure 3. It works on the principal that the polarization of incident light changes upon reflection against a sample [2]. Since I am working with layers, my set up will look more like Figure 4.

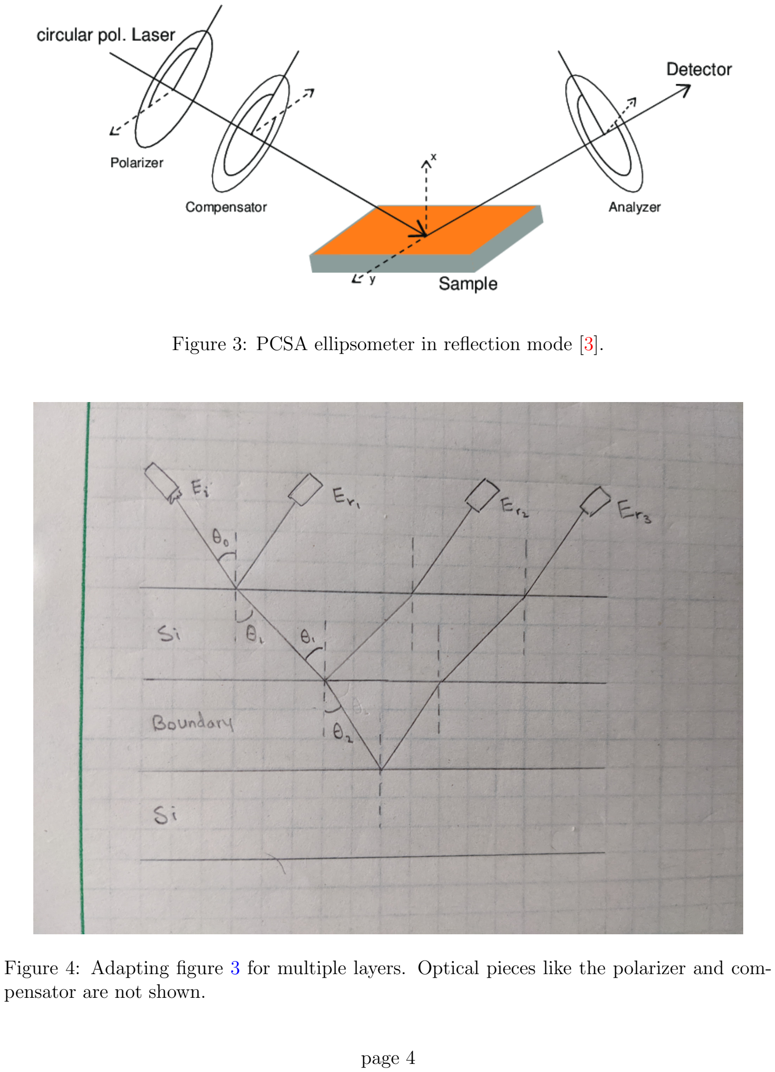
[picture p60: page 5]

Figure 3: PCSA ellipsometer in reflection mode [3].

Figure 4: Adapting figure 3 for multiple layers. Optical pieces like the polarizer and compensator are not shown.

Basic parts list:

1. Laser source
- It will be 1550 nm.
- I may be able to replace it with an IR LED.
2. Linear polarizer
3. Compensator (optional?)
- ”Introduces a defined phase retardation of one field component with respect to the orthogonal field component, the sample S, the analyzer A, and a detector” [3].
- I am a bit confused on what this part does, to be frank. It appears to be optional for reasons that I do not understand.
4. Sample
- I believe I will be able to use the same size wafers as the shear strength experiment. As I will elucidate after this list, I have been struggling with doing the exact math, so this is just based on reading a several papers which used OOM 10mm x 10m x 1mm thin films.
5. Detector

Actually putting this technique into practice is not straightforward—at least for someone like me who does not have an abundance of experience with experimental optics, although based on the papers I read, this does appear to be a difficult problem in general. The math is all linear algebra, but due to the number of variables, actually doing the calculations is quite overwhelming, especially when I am struggling to understand what is happening conceptually. Having an unknown index of refraction and an unknown thickness adds a lot of complexity to the problem, and some sources imply that it may not be able to resolve both values, or you may only be able to find a relative value [4]. There are also limits to capabilities of ellipsometry, as the changes in index of refraction may be so small that they are virtually undetectable [5]. The diagram in Figure 3 is also considered the simplest case; due to the complexity of my specific experiment, I may need to use a more complicated form of ellipsometry.

### 1.3 Mechanical q

In progress...

## References

[1] H´elie, David, et al., Reinforced direct bonding of optical materials by femtosecond laser welding. Applied optics 51.12 p.2098-2106 (2012).
[2] He, Mengfei, and Sidney R. Nagel, Ellipsometry of layered systems. Optical Characterization of Thin Solid Films. Springer, Cham, p.233-267 (2018).
[3] Kurz, Volker Luiz Siegmar., Orientation, conformation and phase transitions of thin polymer films and self-assembled monolayers studied by SFG spectroscopy. Diss. (2010).
[4] Zawada, A., Determining the refractive index, absolute thickness and local slope of a thin transparent film using multi-wavelength and multi-incident-angle interference. Optics Express 28.16 p.24198-24213 (2020).
[5] Kalkowski, Gerhard, et al., Glass-glass direct bonding. ECS Transactions 64.5 p.3 (2014).
