chaotic-distractor/optical_contacting/_SURF2022/parts_list/graphics/basic_ellipsometry.jpg

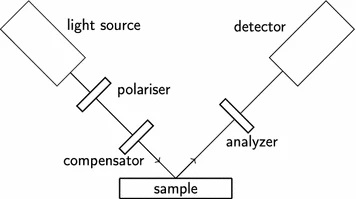
_SURF2022/parts_list/graphics/basic_ellipsometry.jpg
