chaotic-distractor/optical_contacting/_SURF2022/report/LIGO_SURF_Interim_Report_2_draft1/parts_list/graphics/elbow_PXL_20220712_223449788.MP.jpg

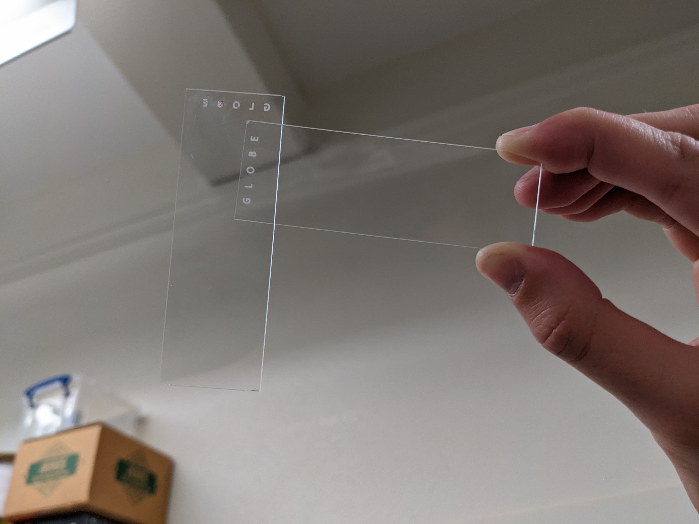
_SURF2022/report/LIGO_SURF_Interim_Report_2_draft1/parts_list/graphics/elbow_PXL_20220712_223449788.MP.jpg
