chaotic-distractor/optical_contacting/for_elog/lab_log_photos/correct_assembly_PXL_20221020_042855181.MP.jpg

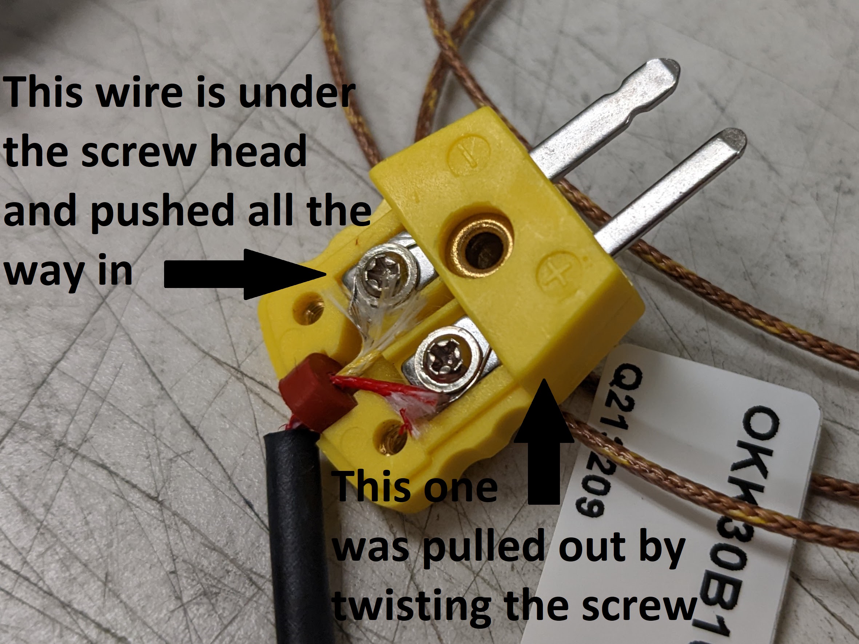
for_elog/lab_log_photos/correct_assembly_PXL_20221020_042855181.MP.jpg
