chaotic-distractor/optical_contacting/for_elog/cycler_v1_graphs/PWM_test_2.txt

0	20.2
30	22.9
60	30.9
90	40.2
120	48.9
150	56.6
180	64.2
210	71.5
240	79.9
270	85.9
300	92.2
330	98.5
360	104.5
390	110.3
420	116.0
450	120.3
480	125.3
510	129.5
540	133.7
570	138.5
600	142.9
630	146.1
660	150.0
690	153.4
720	156.6
750	159.7
780	162.1
810	164.5
840	167.3
870	169.7
900	171.4
930	173.4
960	174.8
990	176.7
1020	178.1
1050	180.0
1080	181.4
1110	182.7
1140	184.1
1170	185.2
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
