chaotic-distractor/optical_contacting/for_elog/cycler_v1_graphs/PWM_test_3.txt

0	20.6
30	25.7
60	40.6
90	57.5
120	74.4
150	89.8
180	105.1
210	117.8
240	129.8
270	141.7
300	152.9
330	162.9
360	172.4
390	180.9
420	188.9
450	195.9
480	203.5
510	194.2
540	197.3
570	201.4
600	205.2
630	209.2
660	214.0
690	217.0
720	220.2
750	221.9
