chaotic-distractor/optical_contacting/for_elog/cycler_v2_graphs/PWM_v2.2_test1_actual.txt

0	21.2
15	21.8
30	27.1
45	32.4
60	37.5
75	42.8
90	48.6
105	54.0
120	59.1
135	64.3
150	69.6
165	74.6
180	79.7
195	84.7
210	89.3
225	94.0
240	98.4
255	103.0
270	107.3
285	111.9
300	115.4
315	119.7
330	123.6
345	127.3
360	129.9
375	134.5
390	138.0
405	141.2
420	143.6
435	147.2
450	150.5
465	157.0
480	169.9
495	183.5
510	196.3
525	208.1
540	220.5
555	232.4
570	243.6
585	254.2
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
