chaotic-distractor/optical_contacting/for_elog/cycler_v2_graphs/PWM_v2.3_test1_actual.txt

0	21.9
15	22.8
30	28.6
45	34.2
60	39.8
75	45.0
90	51.1
105	56.6
120	62.2
135	67.5
150	72.6
165	77.9
180	83.4
195	88.2
210	93.1
225	97.6
240	102.2
255	106.6
270	110.9
285	115.0
300	119.2
315	123.2
330	127.0
345	130.6
360	134.6
375	137.9
390	141.1
405	144.3
420	147.6
435	150.9
450	154.3
465	157.8
480	161.5
495	166.0
510	170.0
525	175.4
540	180.6
555	185.9
570	191.2
585	197.1
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
