chaotic-distractor/optical_contacting/for_elog/cycler_v2_graphs/PWM_v2.3_test2_actual.txt

0	21.0
15	23.3
30	29.5
45	37.5
60	45.5
75	53.6
90	61.2
105	68.9
120	76.8
135	84.0
150	91.3
165	98.1
180	105.6
195	111.8
210	118.6
225	125.0
240	131.2
255	137.2
270	142.8
285	148.4
300	153.7
315	159.2
330	165.0
345	170.8
360	177.1
375	183.7
390	190.4
405	197.8
420	204.6
