chaotic-distractor/optical_contacting/for_elog/cycler_v2_graphs/PWM_v2.3_test3.txt

0	20.5
20	21.1
40	24.6
60	28.3
80	32.0
100	36.8
120	39.6
140	43.3
160	46.9
180	50.5
200	54.0
220	57.2
240	60.4
260	63.4
280	66.2
300	69.5
320	72.3
340	75.1
360	77.2
380	80.4
400	83.3
420	85.1
440	88.2
460	89.8
480	92.7
500	94.5
520	97.3
540	98.8
560	101.2
580	102.8
600	105.0
620	106.6
640	108.2
660	109.8
680	111.5
700	113.0
720	114.6
740	116.1
760	117.6
780	119.0
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
