chaotic-distractor/optical_contacting/for_elog/cycler_v2_graphs/PWM_v2.5_test3.txt

0	20.5
20	21.3
40	25.0
60	28.9
80	33.0
100	36.8
120	40.2
140	44.1
160	48.1
180	51.7
200	55.2
220	57.9
240	62.0
260	65.1
280	68.3
300	71.1
320	74.4
340	77.3
360	80.1
380	82.8
400	85.5
420	87.9
440	89.8
460	92.3
480	95.4
500	97.1
520	100.4
540	103.4
560	106.7
580	110.3
600	114.2
620	118.2
640	122.4
660	126.9
680	131.9
700	136.8
720	142.2
740	147.8
760	153.6
780	159.5
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
