chaotic-distractor/optical_contacting/for_elog/cycler_v2_graphs/PWM_v2.6_test1.txt

0	21.7
20	23.4
40	29.6
60	36.1
80	43.8
100	51.3
120	58.4
140	65.3
160	72.4
180	79.3
200	85.6
220	91.7
240	98.2
260	104.0
280	109.7
300	115.2
320	120.4
340	125.5
360	130.2
380	135.1
400	139.8
420	143.9
440	148.1
460	152.5
480	157.0
500	162.2
520	168.0
540	173.8
560	180.3
580	186.9
600	193.3
