chaotic-distractor/optical_contacting/for_elog/cycler_v2_graphs/PWM_v2.6_test2.txt

0	18.9
20	23.9
40	33.8
60	44.8
80	56.2
100	67.0
120	77.3
140	87.3
160	96.8
180	106.7
200	115.8
220	124.5
240	132.5
260	140.5
280	148.3
300	155.6
320	162.0
340	169.2
360	175.3
380	181.3
400	187.3
420	193.0
