chaotic-distractor/optical_contacting/for_elog/cycler_v2_graphs/PWM_v2.6_test3.txt

0	21.0
20	21.5
40	24.8
60	28.2
80	30.8
100	35.1
120	38.3
140	41.8
160	45.1
180	48.5
200	51.6
220	54.7
240	57.9
260	61.1
280	63.9
300	66.7
320	69.6
340	72.0
360	74.4
380	77.1
400	79.8
420	82.0
440	84.8
460	86.3
480	88.9
500	90.7
520	92.9
540	95.8
560	97.7
580	100.3
600	102.6
620	105.6
640	107.8
660	110.2
680	113.2
700	115.7
720	119.3
740	121.8
760	125.0
780	127.7
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
