chaotic-distractor/optical_contacting/for_elog/cycler_v2_graphs/PWM_v2_test1_actual.txt

0	21.0
15	22.8
30	27.3
45	33.7
60	38.7
75	44.5
90	50.1
105	55.8
120	61.4
135	67.0
150	72.2
165	77.7
180	83.2
195	88.3
210	93.3
225	98.2
240	103.2
255	107.6
270	112.3
285	116.4
300	121.1
315	125.0
330	129.0
345	133.5
360	137.4
375	141.4
390	145.4
405	148.9
420	152.5
435	156.1
450	159.1
465	162.3
480	165.6
495	168.5
510	171.2
525	174.0
540	176.3
555	179.0
570	181.8
585	183.9 
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
