chaotic-distractor/optical_contacting/for_elog/cycler_v2_graphs/PWM_v2_test1_calculated_y.txt

20.00
20.30
20.60
20.90
21.20
21.50
21.80
22.10
22.40
22.70
23.00
23.30
23.60
23.90
24.20
24.50
24.80
25.10
25.40
25.70
26.00
26.30
26.60
26.90
27.20
27.50
27.80
28.10
28.40
28.70
29.00
29.30
29.60
29.90
30.20
30.50
30.80
31.10
31.40
31.70
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
