chaotic-distractor/optical_contacting/for_elog/cycler_v2_graphs/PWM_v2_test2_calculated_y.txt

22.40
22.43
22.86
23.29
23.71
24.14
24.57
25.00
25.43
25.86
26.29
26.71
27.14
27.57
28.00
28.43
28.86
29.29
29.71
30.14
30.57
31.00
31.43
31.86
32.29
32.71
33.14
33.57
34.00
34.43
34.86
35.29
35.71
36.14
36.57
37.00
37.43
37.86
38.29
38.71
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
