chaotic-distractor/optical_contacting/for_elog/cycler_v2_graphs/PWM_v2_test2_with_v1.txt

0	19.7
15	22.9
30	30.1
45	38.9
60	48.0
75	57.3
90	65.9
105	74.9
120	83.1
135	91.5
150	99.6
165	108.3
180	115.9
195	123.4
210	130.6
225	138.0
240	145.6
255	152.3
270	159.3
285	164.8
300	170.8
315	176.8
330	182.3
345	187.8
360	193.1
375	198.1
390	203.2
405	208.2
420	212.6
435	217.2
450	221.1
465	224.9
480	228.8
495	232.2
510	235.5
525	239.1
540	242.5
555	245.6
570	249.0
585	251.8
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
