chaotic-distractor/optical_contacting/for_elog/cycler_v1_graphs/PWM Test #1 (first 300 sec).pdf

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

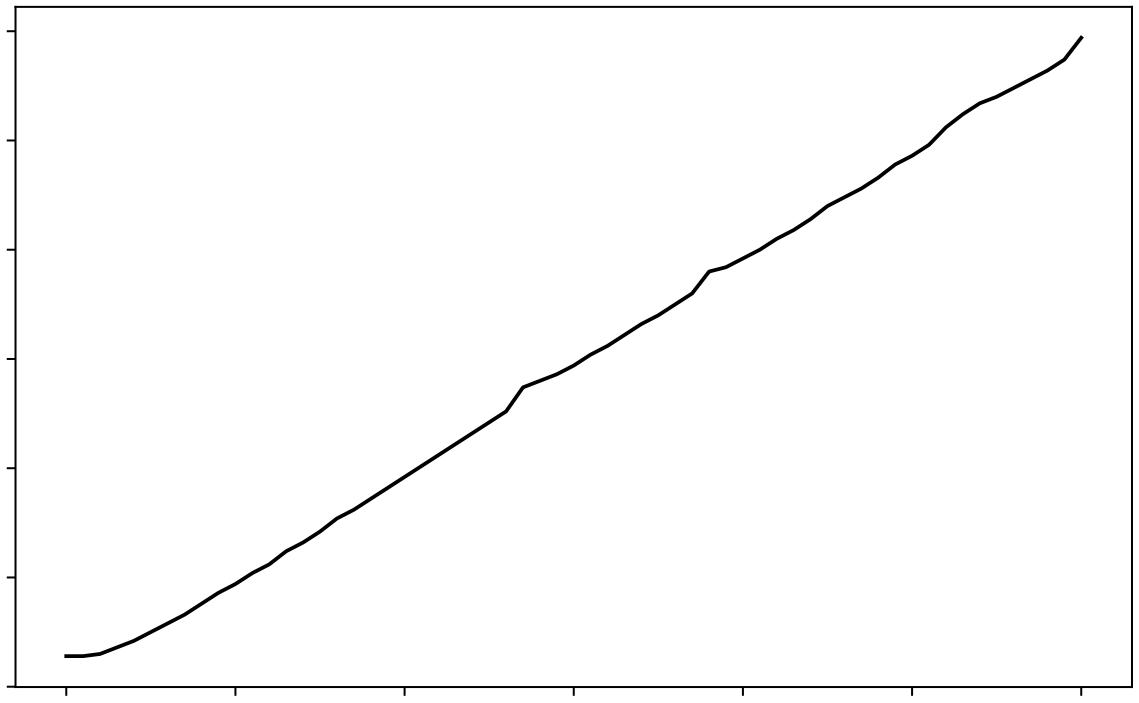
[picture p66: figure]
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
