chaotic-distractor/optical_contacting/for_elog/cycler_v1_graphs/PWM Test #2 (log fit).pdf

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

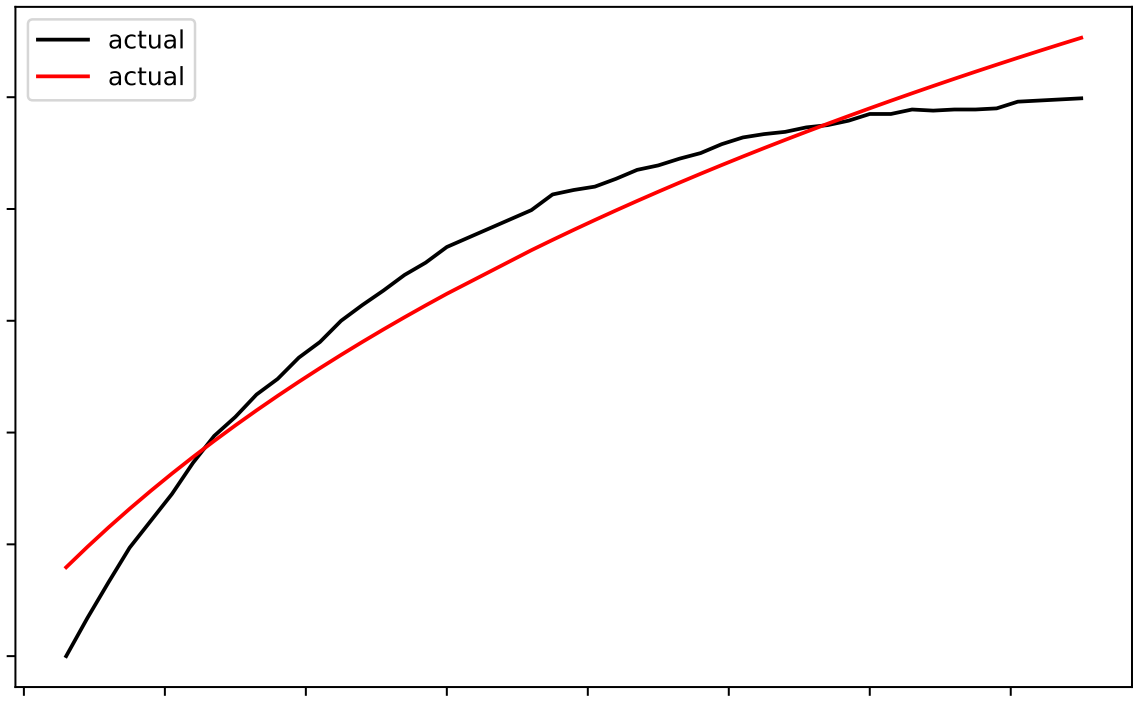
[picture p68: figure]
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
