chaotic-distractor/optical_contacting/for_elog/cycler_v2_graphs/PWM v2 Test #1.pdf

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

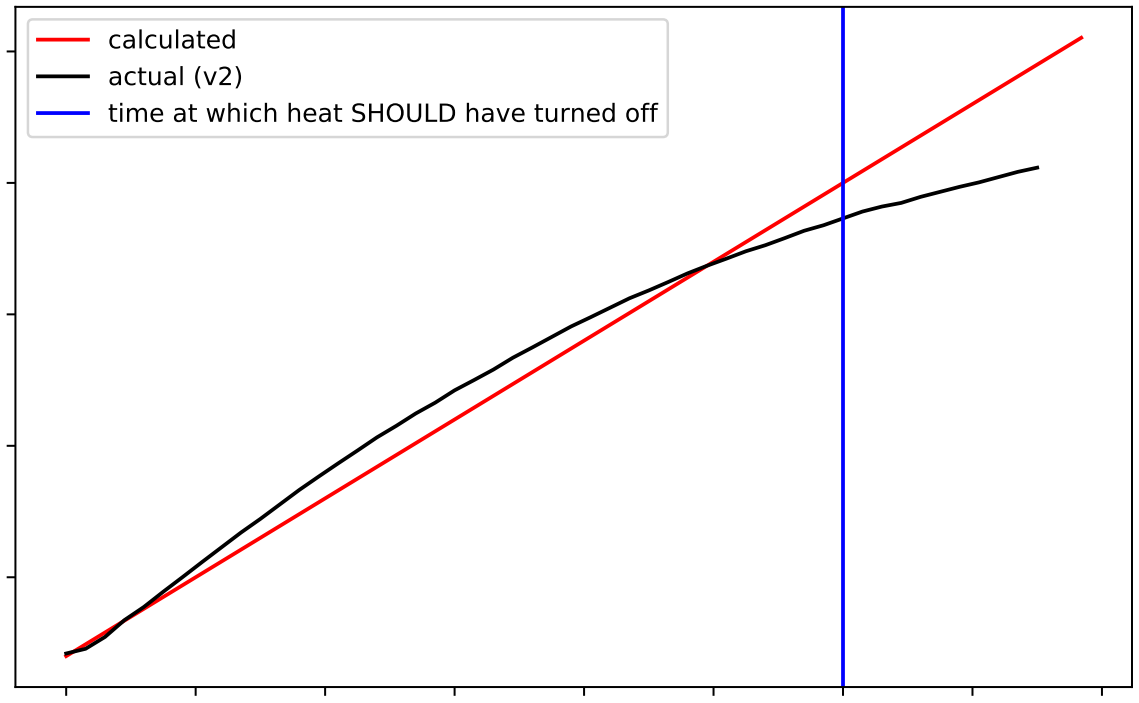
[picture p73: figure]
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
