chaotic-distractor/optical_contacting/for_elog/cycler_v2_graphs/PWM v2.3 Test #2 - increase 180°C in 7 minutes.pdf

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

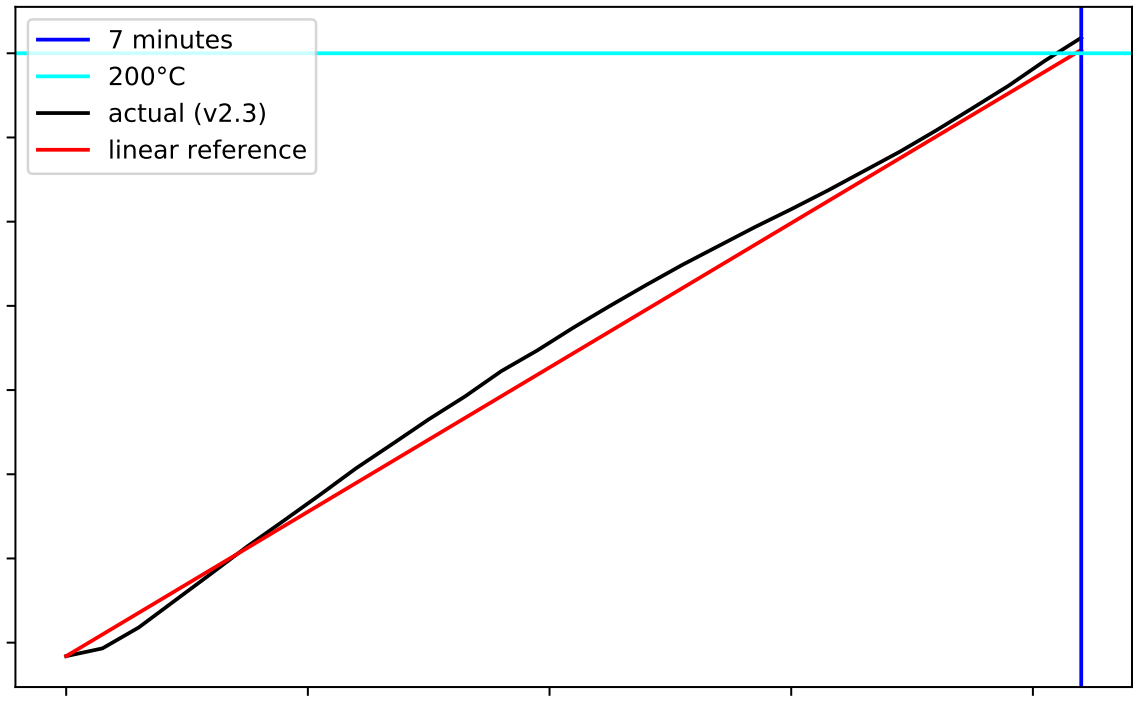
[picture p75: figure]
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
