chaotic-distractor/optical_contacting/for_elog/lab_log_photos/first_real_PWM_test_samples_before_after_PXL_20221018_080838426.MP.jpg

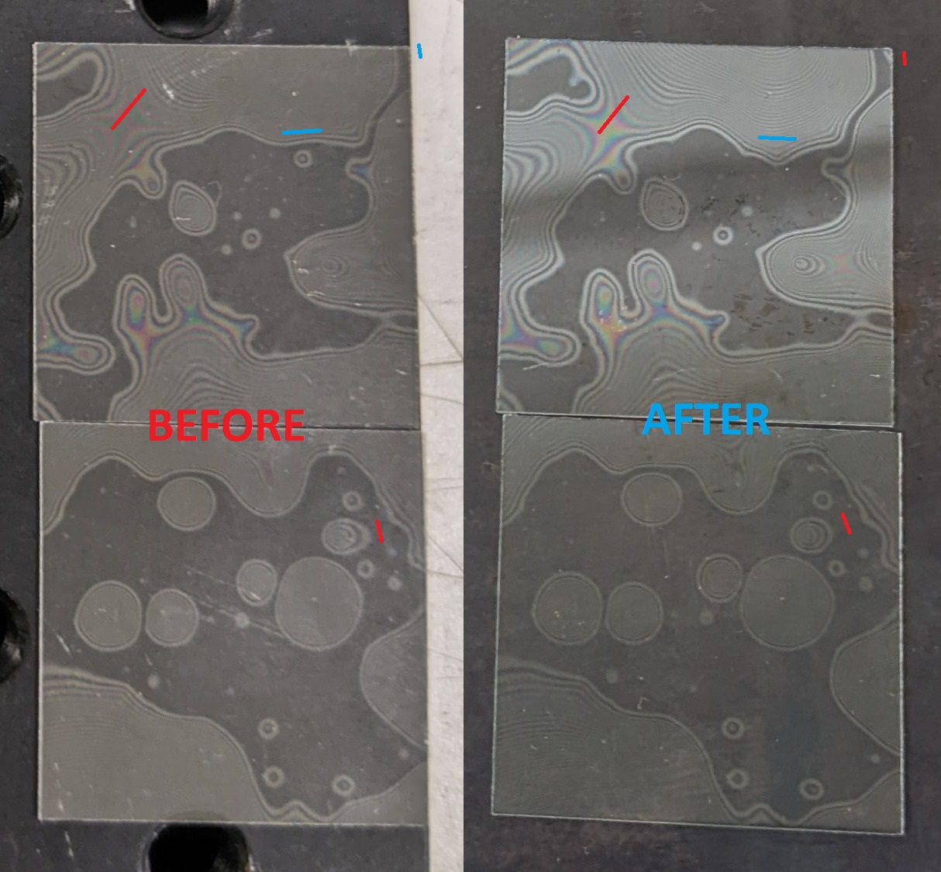
for_elog/lab_log_photos/first_real_PWM_test_samples_before_after_PXL_20221018_080838426.MP.jpg
