chaotic-distractor/optical_contacting/for_elog/lab_log_photos/frame_from_pwm_test1_video_PXL_20221005_064240498_exported_231444.jpg

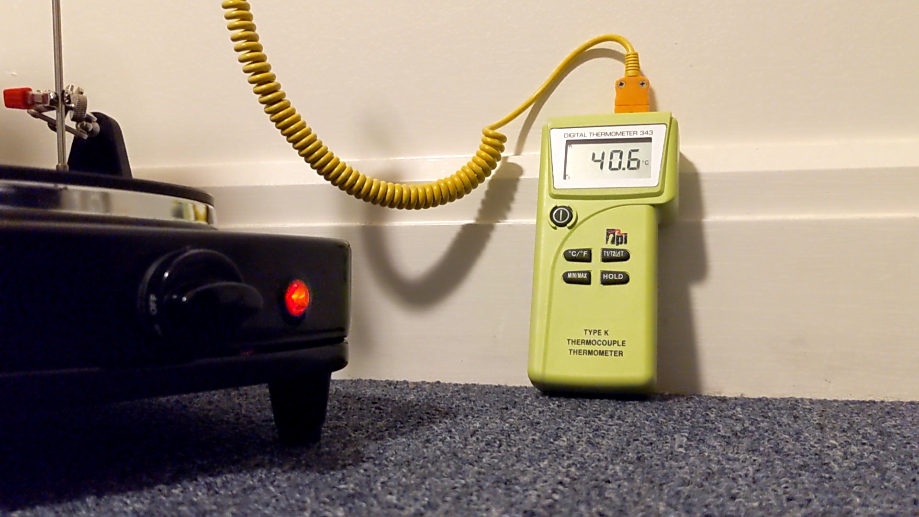
for_elog/lab_log_photos/frame_from_pwm_test1_video_PXL_20221005_064240498_exported_231444.jpg
