chaotic-distractor/optical_contacting/base_hot_plate_timing/time-temp-off-low.pdf

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

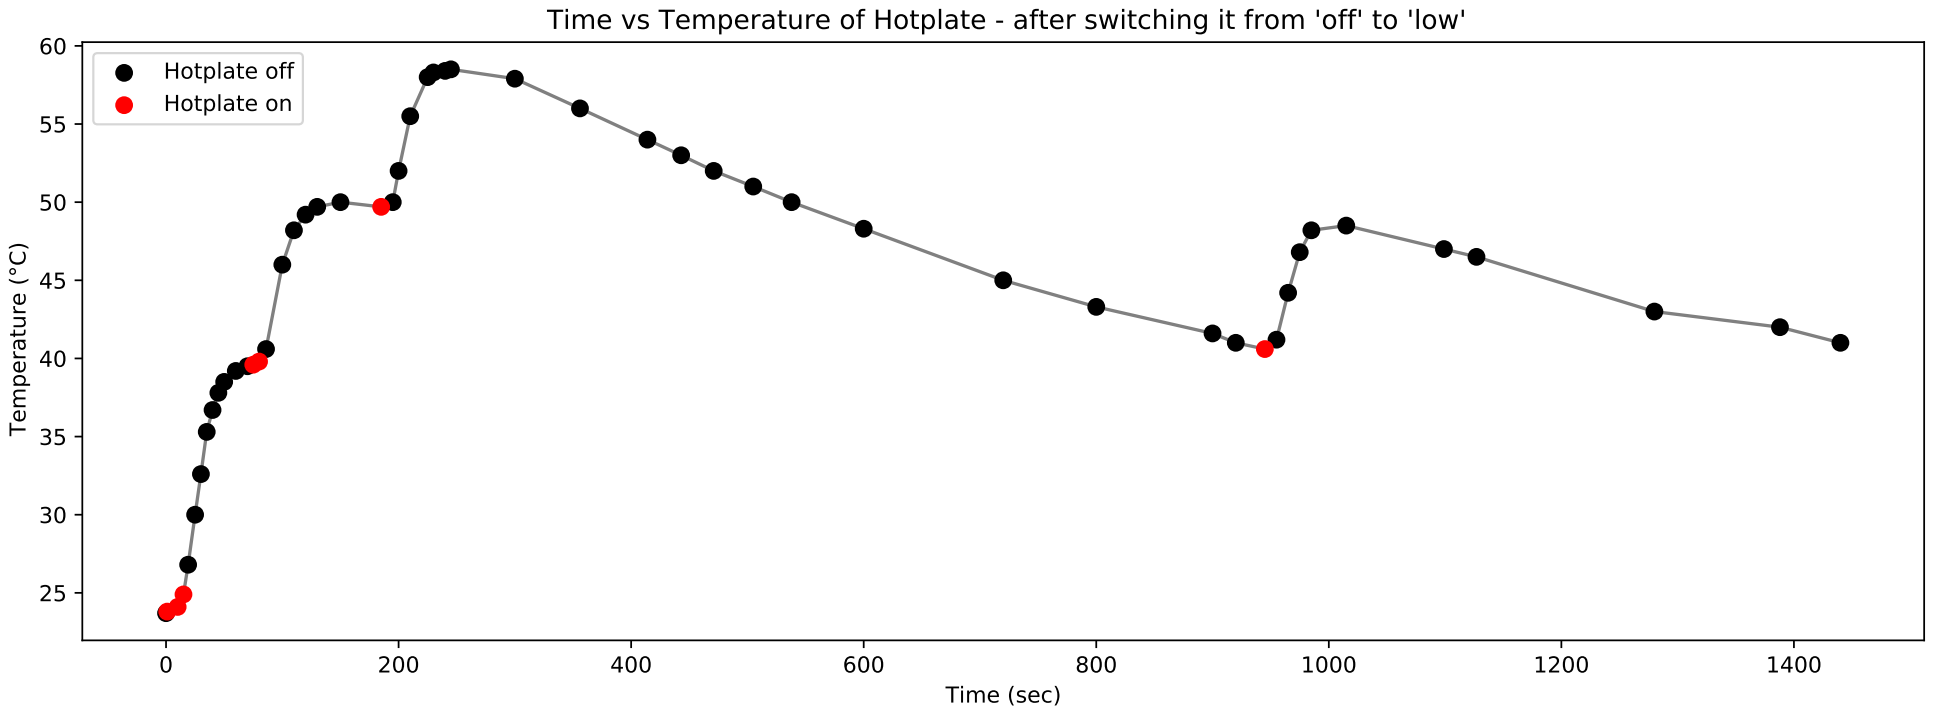
[picture p83: page 1]
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
