chaotic-distractor/optical_contacting/for_elog/cycler_v3_graphs/PWM plates.pdf

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

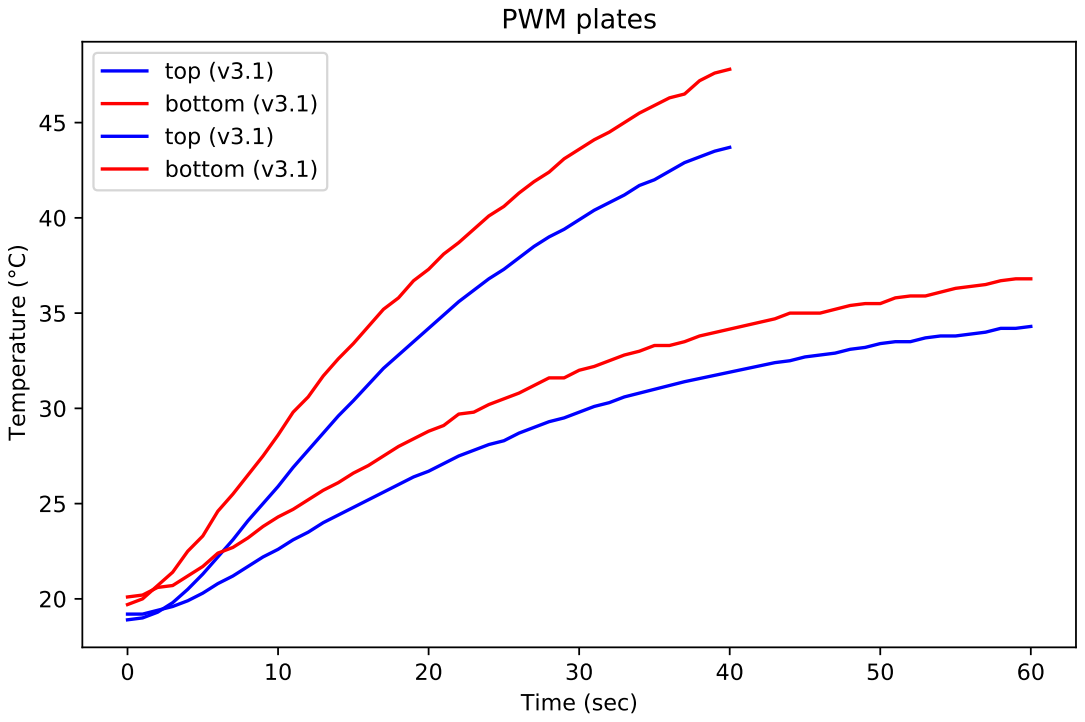
[picture p85: page 1]
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
