chaotic-distractor/optical_contacting/for_elog/cycler_v2_graphs/PWM v2 Test #1 - increase 180°C in 10 minutes.pdf

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

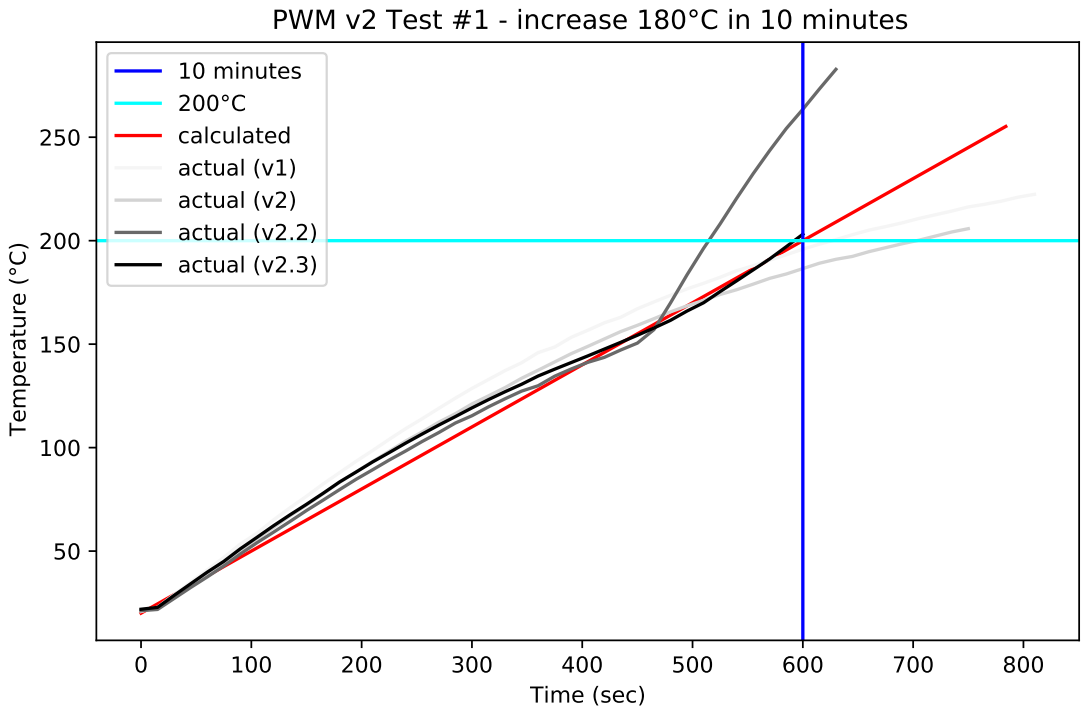
[picture p88: page 1]
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
