chaotic-distractor/optical_contacting/for_elog/cycler_v2_graphs/PWM v2 Test #3 - increase 180°C in 20 minutes.pdf

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

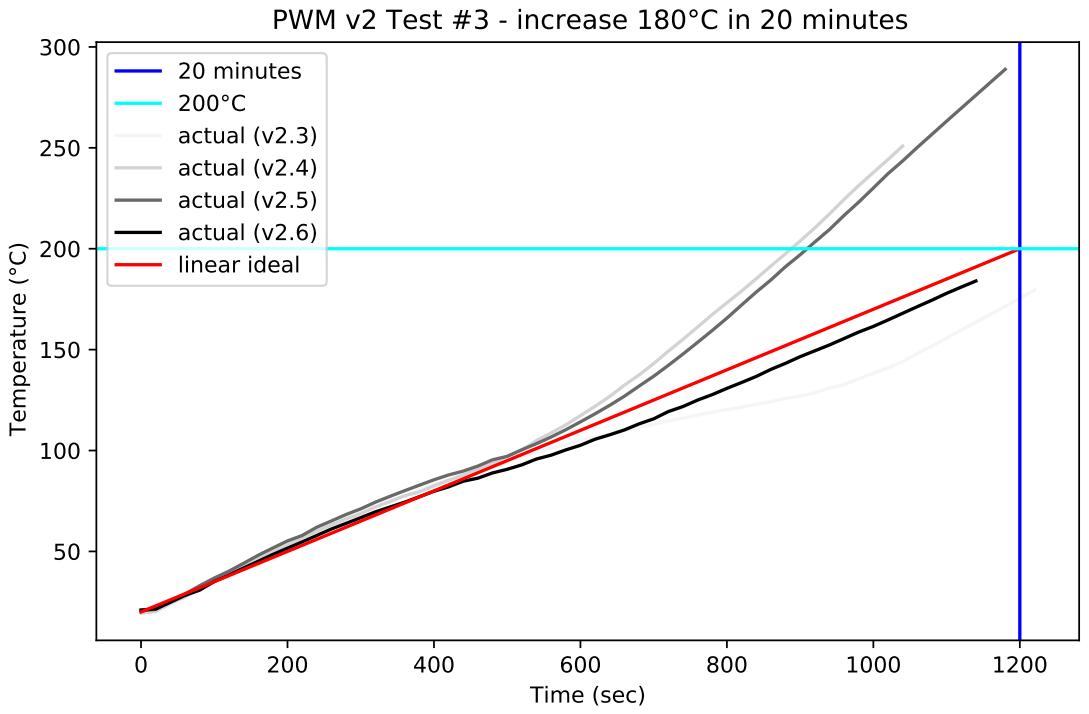
[picture p90: page 1]
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
