chaotic-distractor/optical_contacting/(commit log)

2022-11-13 adding current work
2022-12-08 Added files from my hot plate timing tests
2023-01-13 Add files via upload
    Current progress on receiving temperature readings from the Arduino and communicating them with Jupyter Notebook.
